JensGrabner/snc98_Slash-Number-Calculator/Hardware/Pdf/Switch_mechanical.pdf

< | >
E24 | (<)%
sin | cos | tan | 2

x

lb e

x

ln 10

x

lg
7 | 8 | 9 | ‹
›
CE | ( | ) | Off
sinh | cosh | tanh | Ip
·Fp | Aghm | a^gm
4 | 5 | 6 | ‹
›
< | × | -: | E+3

la

y a

x | x² | x.³ | Std | τ π | r/d // | %./p/
1 | 2 | 3 | Sci | ¹/x | + | - | E−3
Rd x! | °CBp | °FCk | inv | 2nd | M+=
hms | 0 | · | (-) | MCs | EE | FN | =

'-
° ' "
-'--- / ---' | '--Mr-'--M_--'
(·) Ex_ >] | '------DISP------'

show

a

b/c

## snc98 - Slash Number Calculator
