JensGrabner/snc98_Slash-Number-Calculator/Hardware/png/Switch_Calculator.png

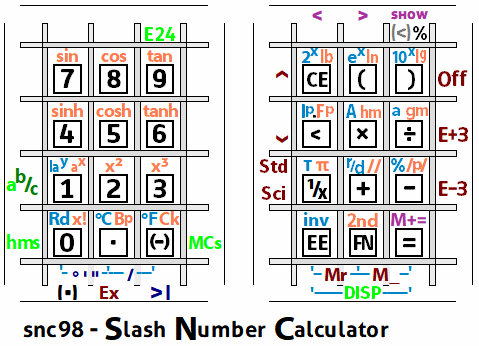
Hardware/png/Switch_Calculator.png
