JensGrabner/snc98_Slash-Number-Calculator/Software/Arduino/Projekte/snc98/Document/Font_HP15.png

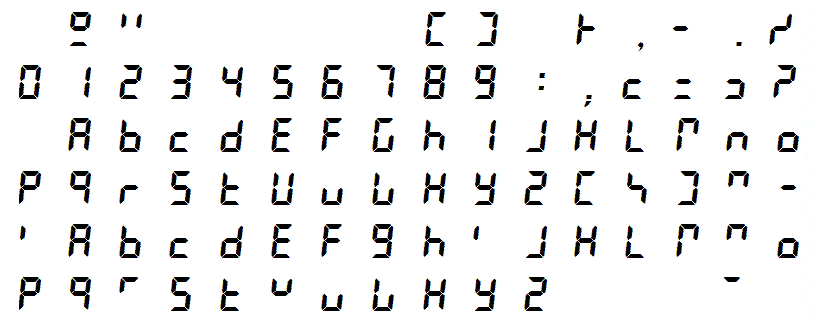
Software/Arduino/Projekte/snc98/Document/Font_HP15.png
