JensGrabner/snc98_Slash-Number-Calculator/Hardware/BOM/BOM_all.xls

Qty | Value | Device | Package | Parts | Description | MF | MPN | OC_FARNELL | OC_NEWARK | PACKAGE | STORE_ID | SUPPLIER | TME_EU
1 | PINHD-1X8 | 1X08-BIG | JP3 | Pin header 1x8 0.1 |  |  | unknown
1 | PINHD-1X9 | 1X09-BIG | JP15 | Pin header 1x9 0.1 |  |  | unknown
2 | PINHD-2X7 | 2X07 | JP13, JP14 | PIN HEADER |  |  | unknown |  |  |  |  |  | ZL231-14PG
2 | PIN_Flachband-2X7 |  |  |  |  |  | DS1016-14MASIBB |  |  |  |  |  | DS1016-14MASIBB
1 | 12MHz | CRYSTALHC49UV | HC49U-V | Y2 | Various standard cry |  |  | unknown
1 | ATMEGA1284P-PU | ATMEGA1284P-PU | DIP254P1524X483-40 | U3 | 8-bit Microcontrolle | MICROCHIP | ATMEGA1284P-PU | 1715481 | 15R0264 | PDIP-40 |  | Atmel
1 | BATTERY-CHARGER-LI-PROT | BATTERY-CHARGER-LI-PROT | BATTERY-CHARGER-LI-PROT | U$1 | Lithium Battery 5V C |  |  | unknown
1 | DS18B20 | DS18B20 | TO-92-AMMO | U2 | Dallas/Maxim DS18B20 |  |  | unknown |  |  | SEN-00245
1 | FTDI | M06LOCK | 1X06_LOCK | JP6 | Header 6 |  |  | unknown |  |  |  |  | ZL202-12G;
1 | ICSP | AVR_SPI_PRG_6 | 2X3_SMD_VERTICAL | JP1 | AVR ISP 6 Pin |  |  | unknown |  |  |  |  | ZL202-6G;
1 | B3F-4150 | TACTILE_SWITCHTACTILE_SWITCH_PTH-12MM | TACTILE-PTH-12MM | S3_c | Momentary Switch | OMRON | B3F4150 | 1960976 |  |  |  |  | B3F-4050
6 | HOLDER_AAA_LEFT1 | HOLDER_AAA_LEFT1 | BATTERY-AAA-LEFT | BH_c_7, BH_c_8, BH_c_9, BH_c_10, BH_c_11, BH_c_12 |  |  |  | unknown |  |  |  |  | BC-0401
1 | SBT1205-3 | BUZZERNS | BUZZER-12MM-NS | SG1 | Buzzer 12mm |  |  | unknown
1 | BCR185 | BCR185 | SOT23-R_INFINEON | T3 | PNP Silicon Digital | ROHM | DTA114YKAT146 | 1680186 |  |  |  |  | MMUN2114LT1G;
2 | BCR135 | BCR135 | SOT23-BEC | T1, T2 | NPN Silicon Digital | INFINEON | BCR135E6327HTSA1 | 2443491RL |  |  |  |  | MMUN2214LT1G;
1 | IRLML6244 | IRLML2502M | SOT-23 | M4 |  | INFINEON | IRLML6244TRPBF | 1864517 |  |  |  |  | DMG2302U-7
4 | IRLML2244 | IRLML6402 | SOT-23 | M1, M2, M3, M12 |  | INFINEON | IRLML2244TRPBF | 2468051 |  |  |  |  | DMG2305UX-7
1 | HT7333 / TS9011SCY | HT7333 | SOT89 | U$3 |  |  |  | unknown |  |  |  |  | TS9011SCY
6 | 1µ | C-EUC1206K | C1206K | C4, C9, C14, C15, C17, C19 | CAPACITOR, European |  |  | unknown |  |  |  |  | CL31B105KOFNNNE
1 | 4µ7 | C-EUC1206K | C1206K | C3 | CAPACITOR, European |  |  | unknown
1 | 74HC4051_MUX | 74HC4051_MUX | SO16 | U1 | 8:1 analog mux |  |  | unknown |  |  |  |  | 74HC4051D.652
9 | 6k8 | R-EU_R1206 | R1206 | R3, R7, R21, R22, R23, R27, R33, R34, R50 | RESISTOR, European s |  |  | unknown |  |  |  |  | SMD0805-6K8-1%
3 | 3k3 | R-EU_M0805 | R1206 | R35, R48, R51 | RESISTOR, European s |  |  | unknown |  |  |  |  | SMD0805-3K3-1%
1 | 1n | CAP0805 | 805 | C11 | Capacitor |  |  | unknown |  |  |  |  | CC0805KPX7R7224
3 | 15n | C-EUC1206K | C1206K | C6, C10, C22 | CAPACITOR, European |  |  | unknown |  |  |  |  | CC0805KRX7R9153
4 | 220nF | CAP0805 | 805 | C2, C12, C16, C18 | Capacitor |  |  | unknown |  |  |  |  | CC0805KPX7R7224
1 | 1k | R-EU_R1206 | R1206 | R20 | RESISTOR, European s |  |  | unknown
2 | 47n | C-EUC1206K | C1206K | C5, C13 | CAPACITOR, European |  |  | unknown |  |  |  |  | CC0805KRX7R9473
3 | 22k | R-EU_R1206 | R1206 | R6, R44, R47 | RESISTOR, European s |  |  | unknown |  |  |  |  | CRCW080522K0FKTABC;
3 | 47k | R-EU_R1206 | R1206 | R1, R28, R46 | RESISTOR, European s |  |  | unknown |  |  |  |  | CRCW080547K0FKTABC;
3 | 150R | R-EU_R1206 | R1206 | R31, R32, R45 | RESISTOR, European s |  |  | unknown |  |  |  |  | CRCW0805150RJNTABC;
2 | 47R | R-EU_R1206 | R1206 | R4, R25 | RESISTOR, European s |  |  | unknown
2 | 22pF | C-USC0805K | C0805K | C7, C8 | CAPACITOR, American |  |  | unknown |  |  |  |  | CL21C220JBANNNC
10 | SD103AW-DIO | DIODESOD-123 | SOD-123F | D02_c, D03_c, D04_c, D05_c, D07_c, D08_c, D09_c, D10_c, D11_c, D12_c |  | MULTICOMP | SD103AW-DIO-7-F | 2306221 |  |  |  |  | SD103AW-DIO;
8 | 3k3 | R-EU_M0805 | M0805 | R33, R34, R35, R44, R45, R46, R47, R48 | RESISTOR, European s |  |  | unknown |  |  |  |  | SMD0805-3K3-1%
8 | IRLML2244 | IRLML6402 | SOT-23 | M4, M5, M6, M7, M8, M9, M10, M11 |  | INFINEON | IRLML2244TRPBF | 2468051 |  |  |  |  | DMG2305UX-7
5 | BC56-12SRWA | BC56-12SRWA | BX56-12 | LED1, LED2, LED3, LED4, LED5 | 14.22mm (0.56INCH) T |  |  | unknown |  | LTD056AUE-103C;
2 | MICROMATCH-14 | MICROMATCH-14 | MICROMATCH-14 | X2, X4 | MicroMaTch 14 8-215 | AMP - TE CONNECTIVITY | 8-215464-4 | 3784678 | 19J6431 | DS1015-02-14R6;
3 | HOLDER_AAA_LEFT1 | HOLDER_AAA_LEFT1 | BATTERY-AAA-LEFT | BH_d_4, BH_d_5, BH_d_6 |  |  |  | unknown |  |  |  |  | BC-0401
3 | 6k8 | R-EU_M0805 | M0805 | R7_a, R8_a, R33_a | RESISTOR_a, European s |  |  | unknown |  |  |  |  | SMD0805-6K8-1%
12 | B3F-4150 | TACTILE_SWITCHTACTILE_SWITCH_PTH-12MM | TACTILE-PTH-12MM | S1_a, S2_a, S3_a, S4_a, S5_a, S6_a, S7_a, S8_a, S9_a, S10_a, S11_a, S12 | Momentary Switch |  | B3F4150 | 1960976 |  |  |  |  | B3F-4050
1 | M09LOCK-LONGPADS | M08LOCK-LONGPADS | 1X08_LOCK_LONGPADS | JP1_a | Header 8 |  |  | unknown | ;
12 | SD103AW-DIO | DIODESOD-123 | SOD-123F | D01_a, D02_a, D03_a, D04_a, D05_a, D06_a, D07_a, D08_a, D09_a, D10_a, D11_a, D12_a |  | MULTICOMP | SD103AW-DIO-7-F | 2306221 |  |  |  |  | SD103AW-DIO;
3 | 15n | C-EUC1206K | C1206K | C10_b, C11_b, C12_b | CAPACITOR_b, European |  |  | unknown |  |  |  |  | CC0805KRX7R9153
3 | 27k | R-EU_M0805 | M0805 | R9_b, R10_b, R11_b | RESISTOR_b, European s |  |  | unknown | RC0805FR-0727K;
3 | 6k8 | R-EU_M0805 | M0805 | R7_b, R8_b, R33_b | RESISTOR_b, European s |  |  | unknown |  |  |  |  | SMD0805-6K8-1%
12 | B3F-4150 | TACTILE_SWITCHTACTILE_SWITCH_PTH-12MM | TACTILE-PTH-12MM | S1_b, S2_b, S3_b, S4_b, S5_b, S6_b, S7_b, S8_b, S9_b, S10_b, S11_b, S12_b | Momentary Switch |  | B3F4150 | 1960976 |  |  |  |  | B3F-4050
1 | M09LOCK-LONGPADS | M09LOCK-LONGPADS | 1X09_LOCK_LONGPADS | JP1_b | Header 9 |  |  | unknown | ;
12 | SD103AW-DIO | DIODESOD-123 | SOD-123F | D01_b, D02_b, D03_b, D04_b, D05_b, D06_b, D07_b, D08_b, D09_b, D10_b, D11_b, D12_b |  | MULTICOMP | SD103AW-DIO-7-F | 2306221 |  |  |  |  | SD103AW-DIO;
