JensGrabner/snc98_Slash-Number-Calculator/Hardware/qcad/Switch_mechanical.dxf

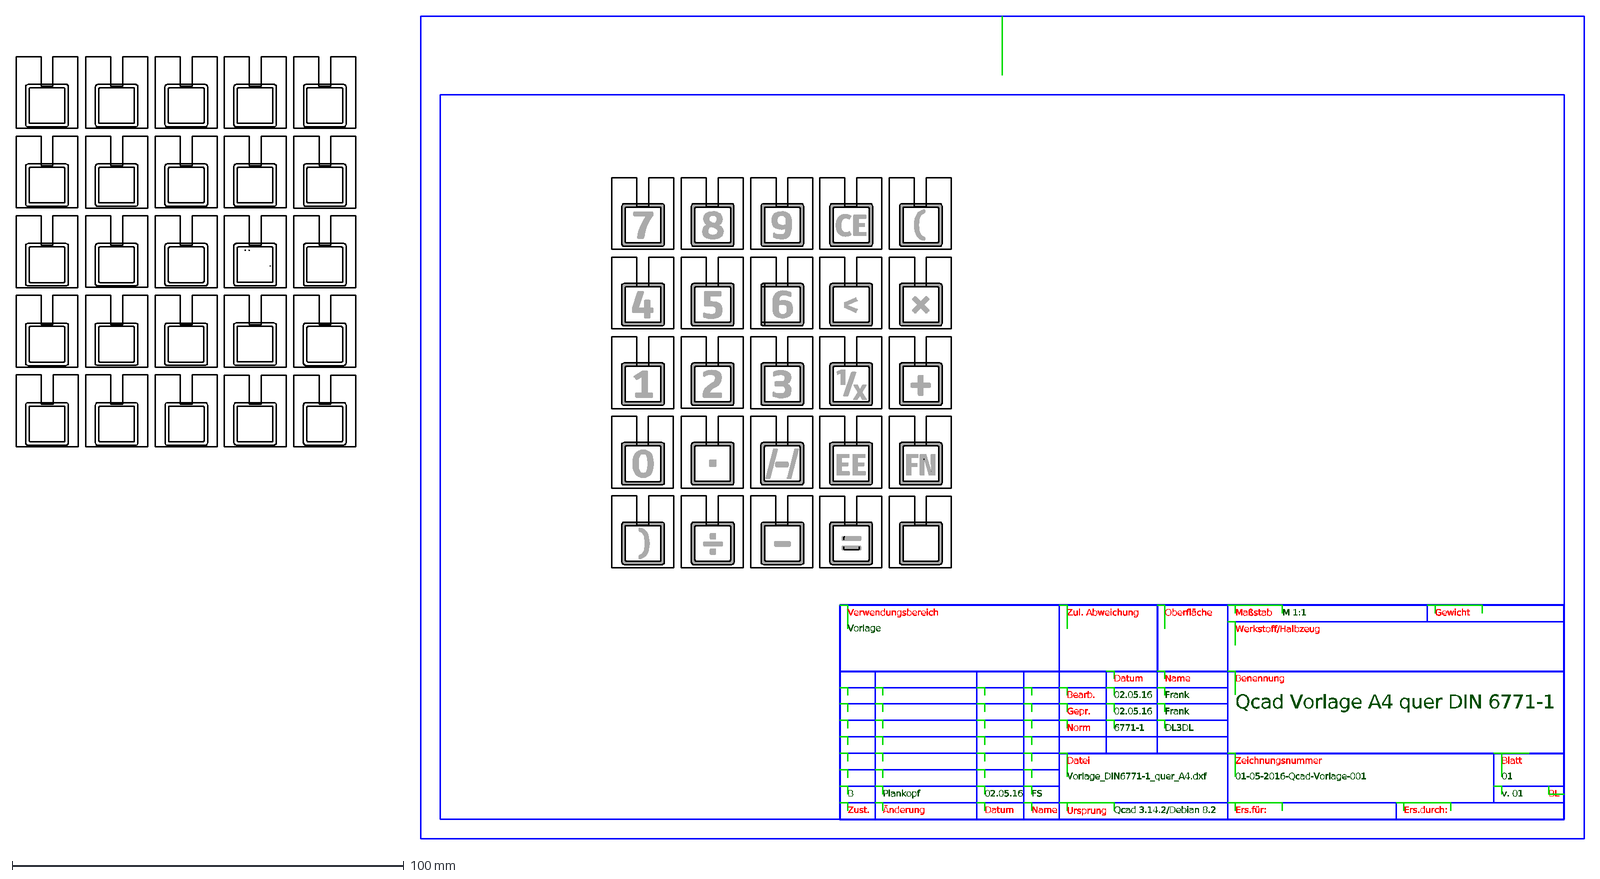
[picture p3: CAD file, 2017-12-26]
Hardware/qcad/Switch_mechanical.dxf
Verwendungsbereich
Zul. Abweichung
Oberfläche
Maßstab
Gewicht
Datum
Name
Bearb.
Gepr.
Norm
Zust.
Änderung
Ursprung
Ers.für:
Ers.durch:
Werkstoff/Halbzeug
Benennung
Zeichnungsnummer
Blatt
BL
B
Plankopf
02.05.16
FS
6771-1
Frank
Datei
Vorlage_DIN6771-1_quer_A4.dxf
01-05-2016-Qcad-Vorlage-001
01
v. 01
Vorlage
M 1:1
Qcad Vorlage A4 quer DIN 6771-1
Qcad 3.14.2/Debian 8.2
DL3DL
