JensGrabner/snc98_Slash-Number-Calculator/Software/Arduino/Projekte/snc98/Document/qbrt_test.xls

 |  |  | 4.12 | bit |  |  | 3.63 | bit |  |  | 7.27 | bit |  |  | 5.97 | bit |  |  | 10.39 | bit
0.125 | 0.500 | 0.5287 | 4.12 |  | 0.500 | 0.5403 | 3.63 |  | 0.500 | 0.5033 | 7.27 |  | 0.500 | 0.5080 | 5.97
0.130 | 0.507 | 0.532 | 4.33 |  | 0.507 | 0.543 | 3.79 |  | 0.507 | 0.509 | 7.80 |  | 0.507 | 0.513 | 6.37
0.135 | 0.513 | 0.535 | 4.56 |  | 0.513 | 0.546 | 3.96 |  | 0.513 | 0.514 | 8.51 |  | 0.513 | 0.517 | 6.84
0.140 | 0.519 | 0.538 | 4.81 |  | 0.519 | 0.549 | 4.13 |  | 0.519 | 0.520 | 9.69 |  | 0.519 | 0.522 | 7.47
0.145 | 0.525 | 0.541 | 5.09 |  | 0.525 | 0.552 | 4.32 |  | 0.525 | 0.525 | 13.07 |  | 0.525 | 0.527 | 8.45
0.150 | 0.531 | 0.544 | 5.41 |  | 0.531 | 0.555 | 4.51 |  | 0.531 | 0.531 | 9.62 |  | 0.531 | 0.532 | 11.34
0.155 | 0.537 | 0.547 | 5.80 |  | 0.537 | 0.557 | 4.73 |  | 0.537 | 0.536 | 8.79 |  | 0.537 | 0.536 | 9.08
0.160 | 0.543 | 0.550 | 6.29 |  | 0.543 | 0.560 | 4.96 |  | 0.543 | 0.541 | 8.32 |  | 0.543 | 0.541 | 8.03
0.165 | 0.548 | 0.553 | 6.97 |  | 0.548 | 0.563 | 5.22 |  | 0.548 | 0.546 | 8.02 |  | 0.548 | 0.545 | 7.48
0.170 | 0.554 | 0.556 | 8.18 |  | 0.554 | 0.566 | 5.52 |  | 0.554 | 0.551 | 7.81 |  | 0.554 | 0.550 | 7.12
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
