JensGrabner/snc98_Slash-Number-Calculator/Hardware/Pdf/snc98_3x4_Switch-block_brd.pdf

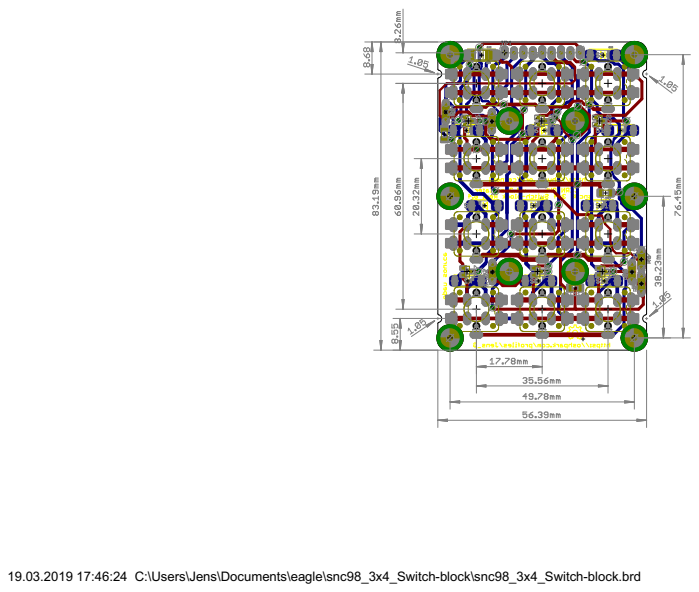
[picture p4: page 1]

19.03.2019 17:46:24 C:\Users\Jens\Documents\eagle\snc98_3x4_Switch-block\snc98_3x4_Switch-block.brd
