JensGrabner/snc98_Slash-Number-Calculator/Hardware/Pdf/snc98_3x4_Switch-block_sch.pdf

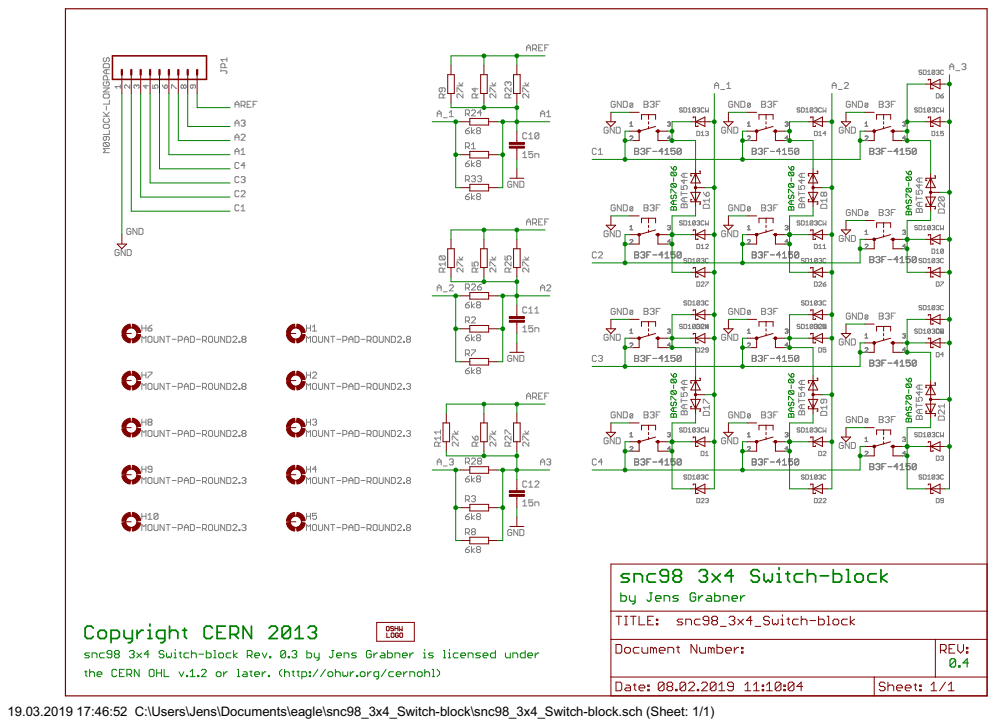
[picture p5: page 1]

19.03.2019 17:46:52 C:\Users\Jens\Documents\eagle\snc98_3x4_Switch-block\snc98_3x4_Switch-block.sch (Sheet: 1/1)
