JensGrabner/snc98_Slash-Number-Calculator/Hardware/Pdf/snc98_Display_15x7-Seg_3-digit_LTD056_brd.pdf

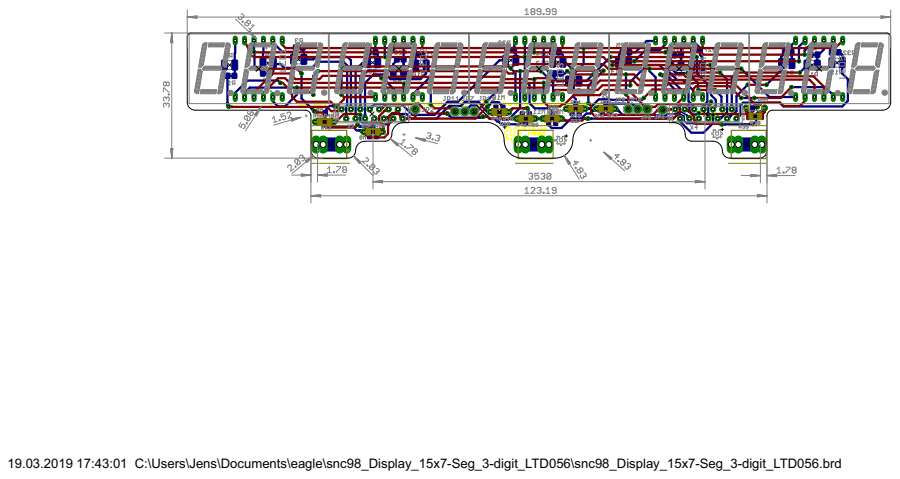
[picture p6: page 1]

19.03.2019 17:43:01 C:\Users\Jens\Documents\eagle\snc98_Display_15x7-Seg_3-digit_LTD056\snc98_Display_15x7-Seg_3-digit_LTD056.brd
