JensGrabner/snc98_Slash-Number-Calculator/Hardware/Pdf/snc98_Display_15x7-Seg_3-digit_LTD056_sch.pdf

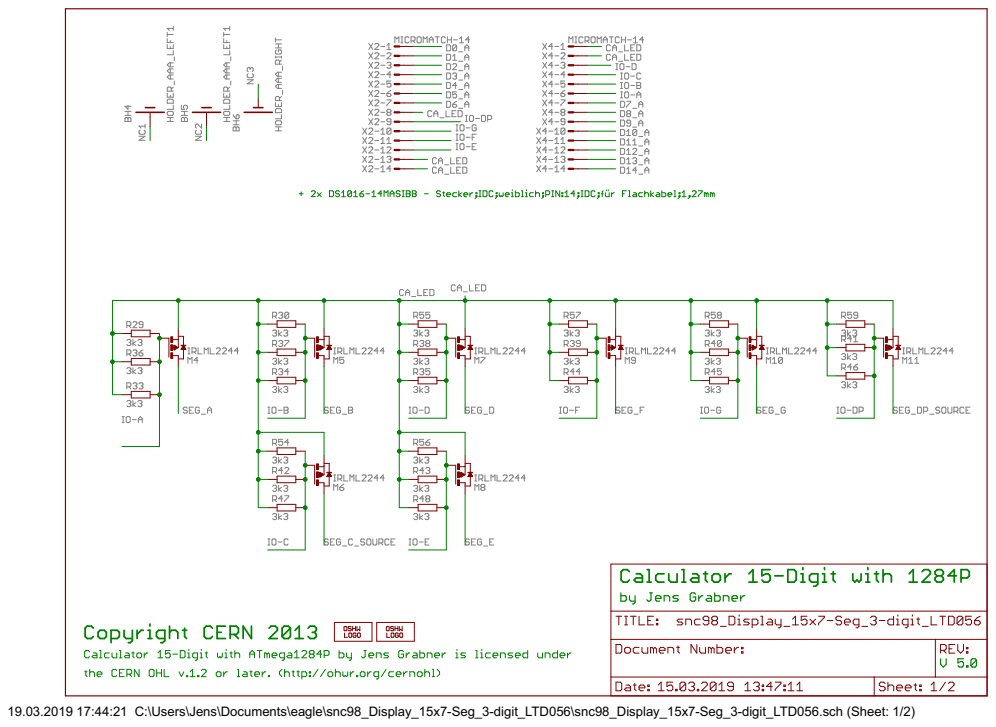
[picture p7: page 1]

19.03.2019 17:44:21 C:\Users\Jens\Documents\eagle\snc98_Display_15x7-Seg_3-digit_LTD056\snc98_Display_15x7-Seg_3-digit_LTD056.sch (Sheet: 1/2)

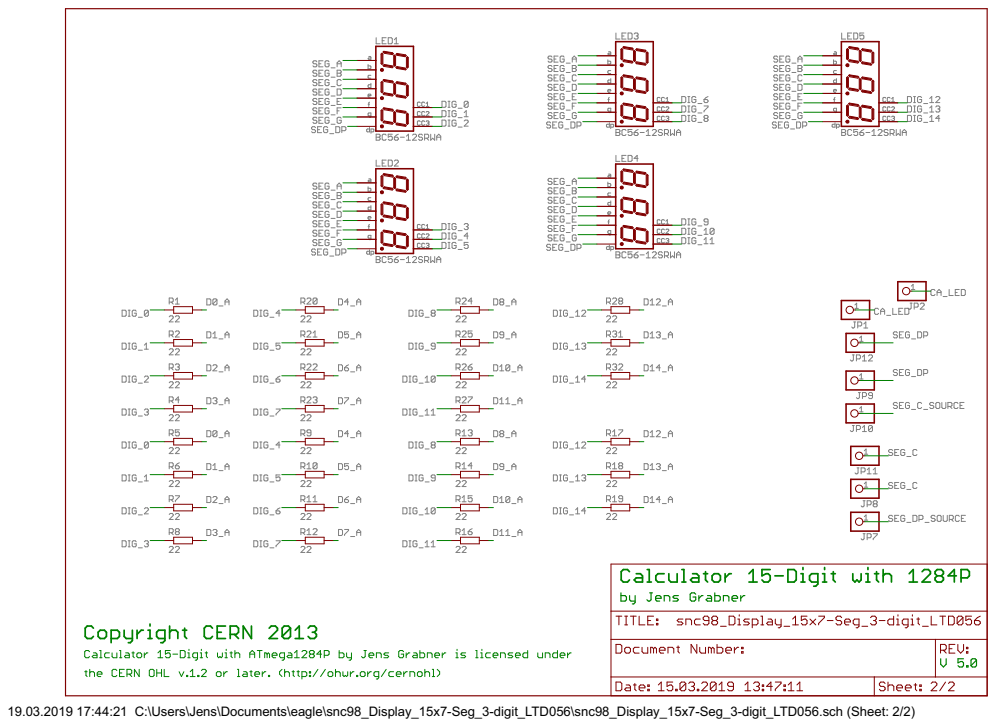
[picture p8: page 2]

19.03.2019 17:44:21 C:\Users\Jens\Documents\eagle\snc98_Display_15x7-Seg_3-digit_LTD056\snc98_Display_15x7-Seg_3-digit_LTD056.sch (Sheet: 2/2)
