JensGrabner/snc98_Slash-Number-Calculator/Hardware/Pdf/snc98_keyboard_plate_brd.pdf

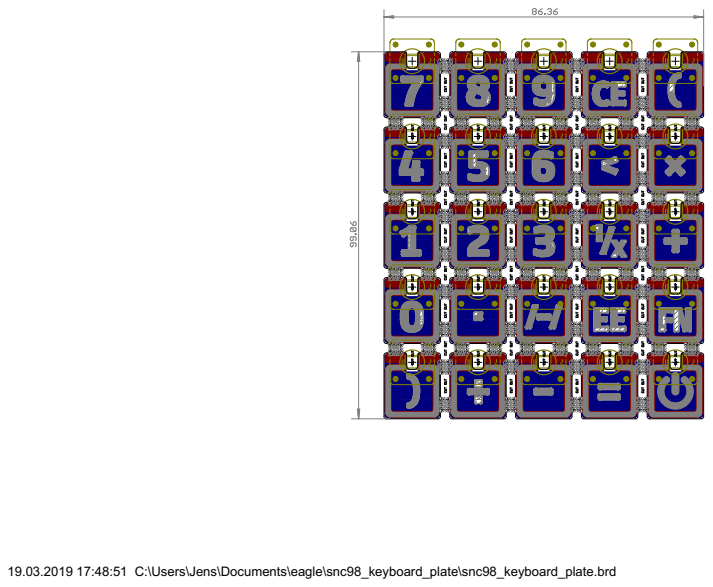
[picture p9: page 1]

19.03.2019 17:48:51 C:\Users\Jens\Documents\eagle\snc98_keyboard_plate\snc98_keyboard_plate.brd
