JensGrabner/snc98_Slash-Number-Calculator/Hardware/Pdf/snc98_keyboard_plate_sch.pdf

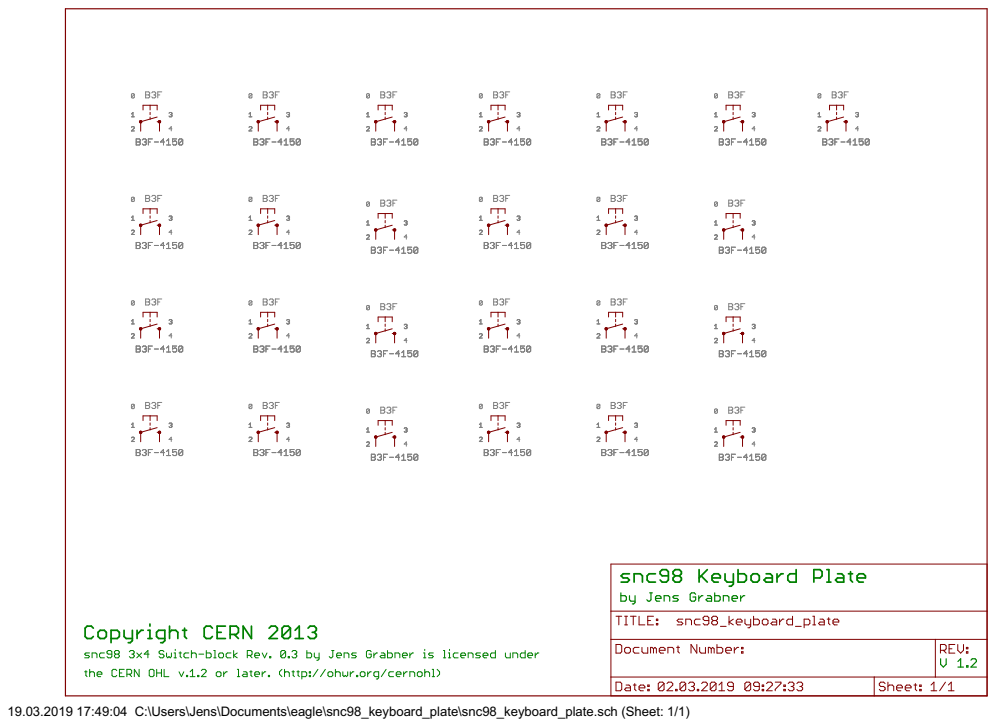
[picture p10: page 1]

19.03.2019 17:49:04 C:\Users\Jens\Documents\eagle\snc98_keyboard_plate\snc98_keyboard_plate.sch (Sheet: 1/1)
