JensGrabner/snc98_Slash-Number-Calculator/Hardware/Pdf/snc98_main_cpu_brd.pdf

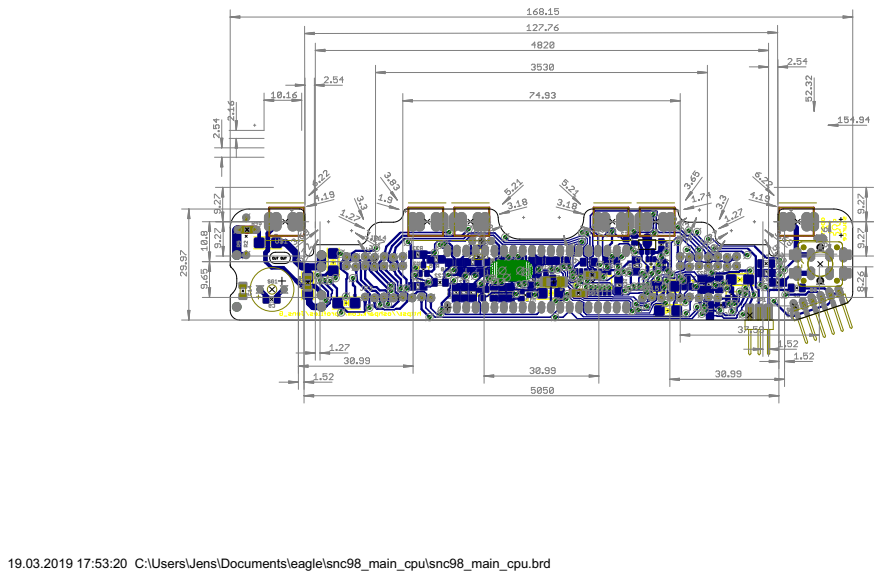
[picture p11: page 1]

19.03.2019 17:53:20 C:\Users\Jens\Documents\eagle\snc98_main_cpu\snc98_main_cpu.brd
