JensGrabner/snc98_Slash-Number-Calculator/Hardware/Pdf/snc98_main_cpu_sch.pdf

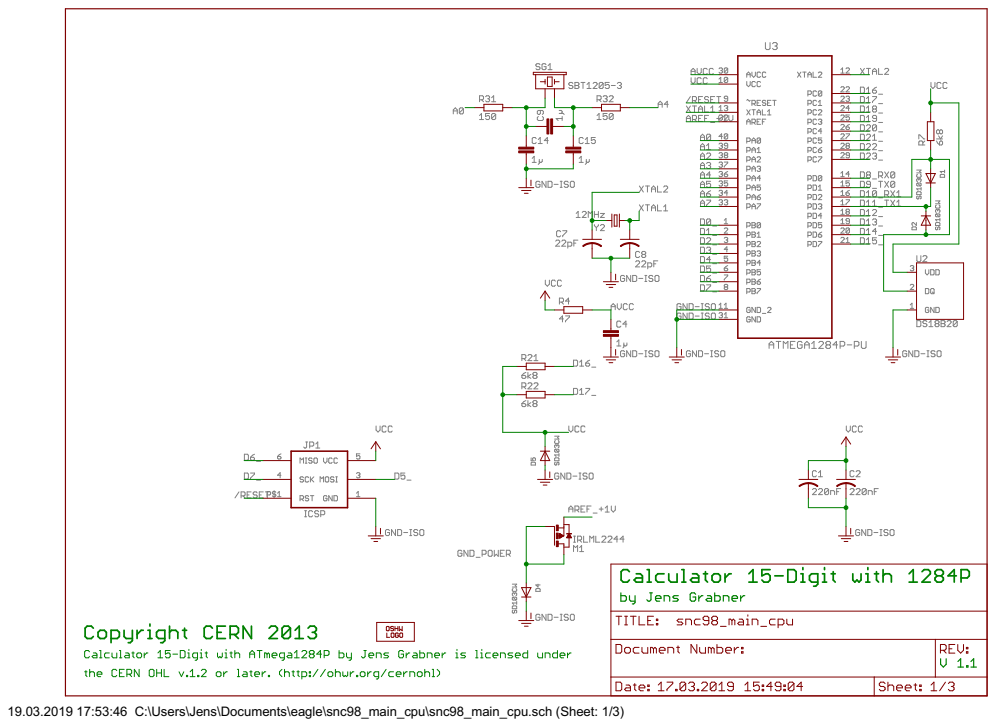
[picture p12: page 1]

19.03.2019 17:53:46 C:\Users\Jens\Documents\eagle\snc98_main_cpu\snc98_main_cpu.sch (Sheet: 1/3)

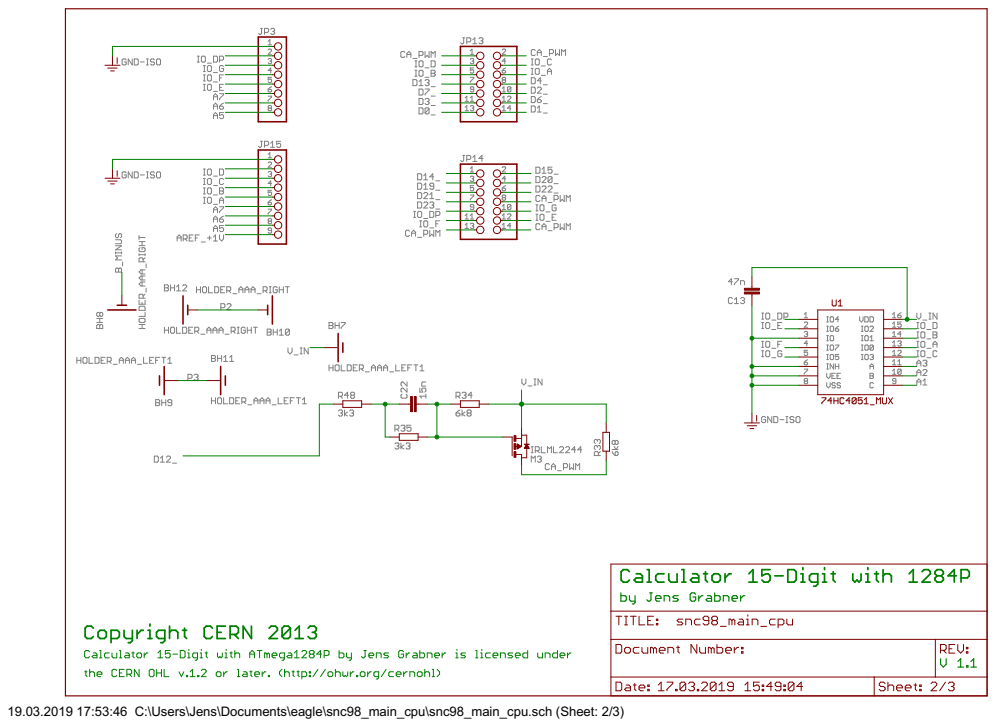
[picture p13: page 2]

19.03.2019 17:53:46 C:\Users\Jens\Documents\eagle\snc98_main_cpu\snc98_main_cpu.sch (Sheet: 2/3)

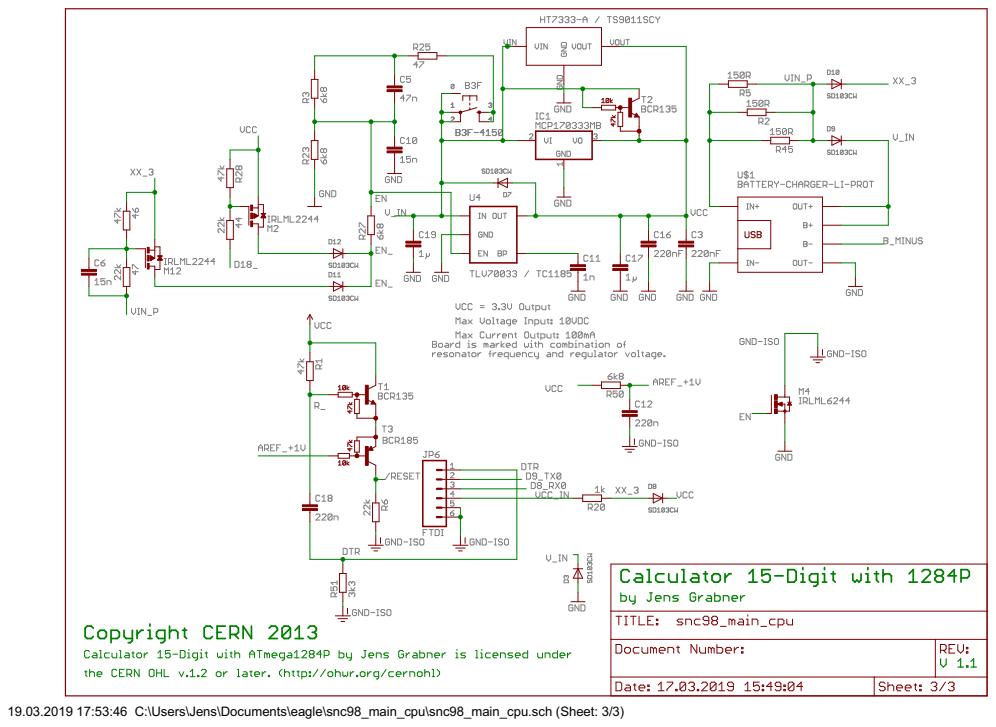
[picture p14: page 3]

19.03.2019 17:53:46 C:\Users\Jens\Documents\eagle\snc98_main_cpu\snc98_main_cpu.sch (Sheet: 3/3)
