JensGrabner/snc98_Slash-Number-Calculator/Hardware/Pdf/snc98_Display_15x7-Seg_1-digit_SC39_brd.pdf

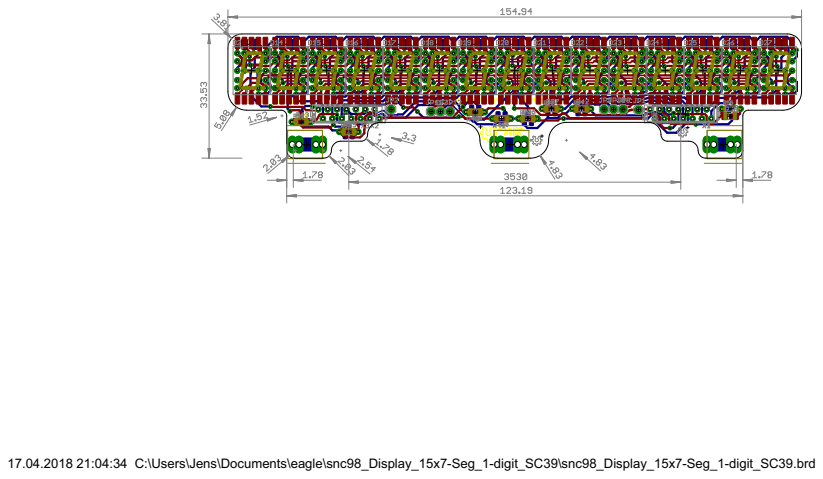
[picture p15: page 1]

17.04.2018 21:04:34 C:\Users\Jens\Documents\eagle\snc98_Display_15x7-Seg_1-digit_SC39\snc98_Display_15x7-Seg_1-digit_SC39.brd
