JensGrabner/snc98_Slash-Number-Calculator/Hardware/Pdf/snc98_Display_15x7-Seg_1-digit_SC39_sch.pdf

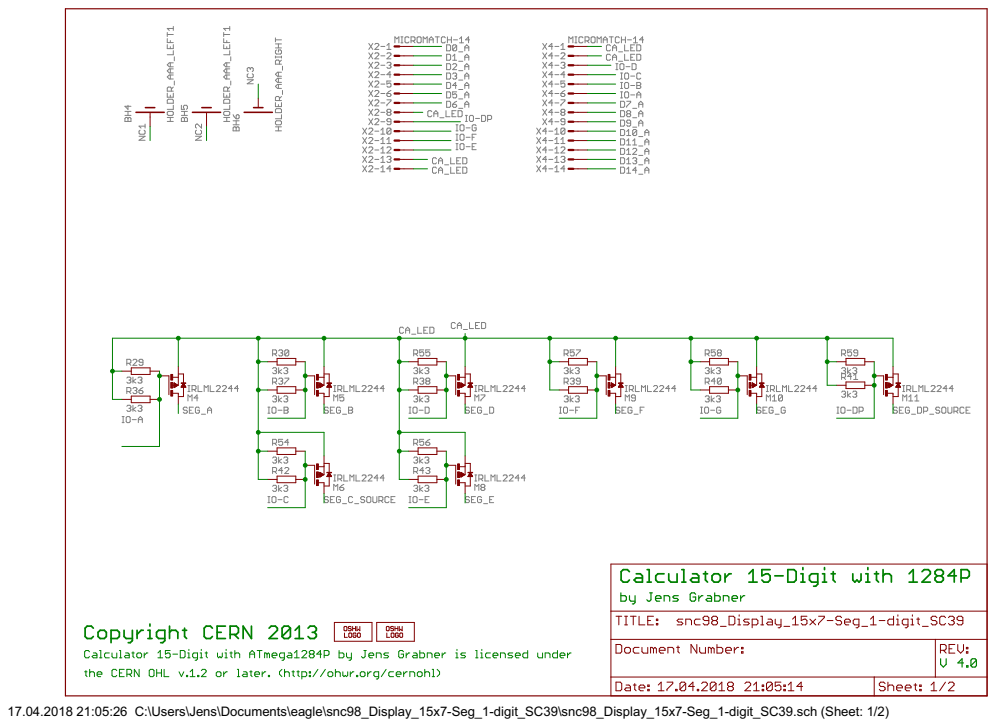
[picture p16: page 1]

17.04.2018 21:05:26 C:\Users\Jens\Documents\eagle\snc98_Display_15x7-Seg_1-digit_SC39\snc98_Display_15x7-Seg_1-digit_SC39.sch (Sheet: 1/2)

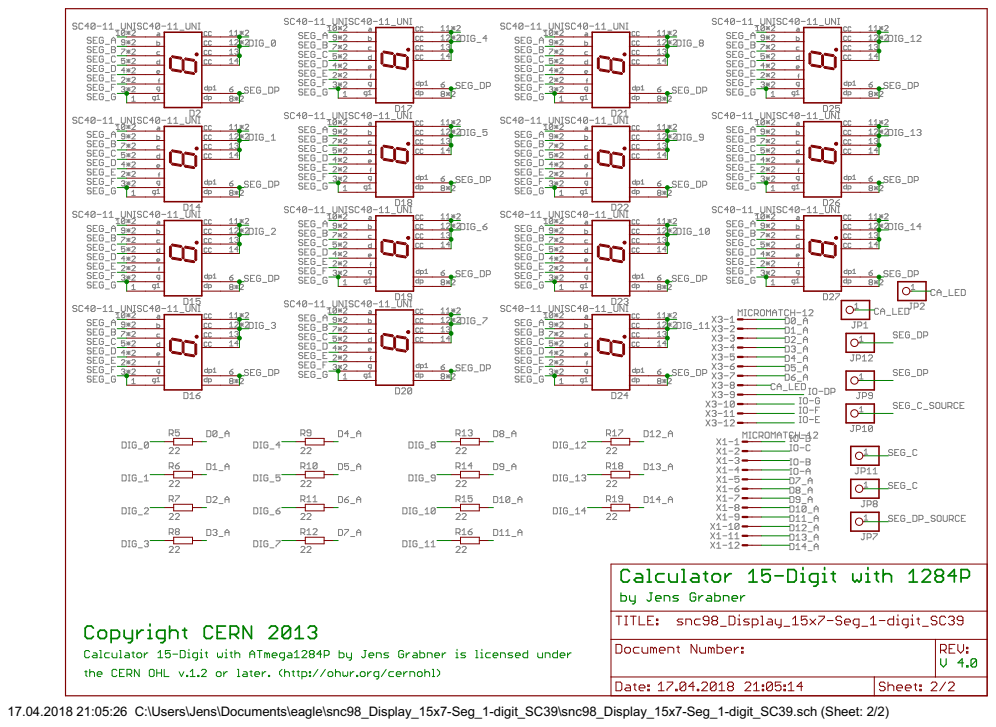
[picture p17: page 2]

17.04.2018 21:05:26 C:\Users\Jens\Documents\eagle\snc98_Display_15x7-Seg_1-digit_SC39\snc98_Display_15x7-Seg_1-digit_SC39.sch (Sheet: 2/2)
