JensGrabner/snc98_Slash-Number-Calculator/Hardware/Pdf/snc98_Display_15x7-Seg_1-digit_SC52_brd.pdf

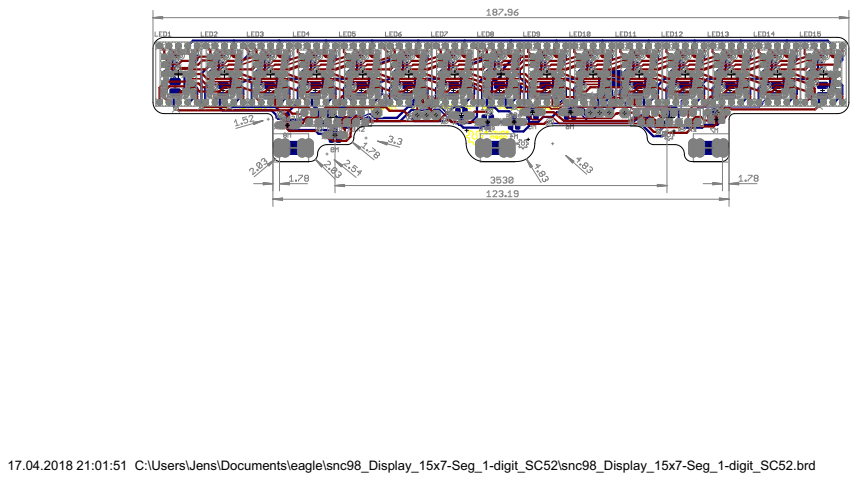
[picture p18: page 1]

17.04.2018 21:01:51 C:\Users\Jens\Documents\eagle\snc98_Display_15x7-Seg_1-digit_SC52\snc98_Display_15x7-Seg_1-digit_SC52.brd
