JensGrabner/snc98_Slash-Number-Calculator/Hardware/Pdf/snc98_Display_15x7-Seg_1-digit_SC52_sch.pdf

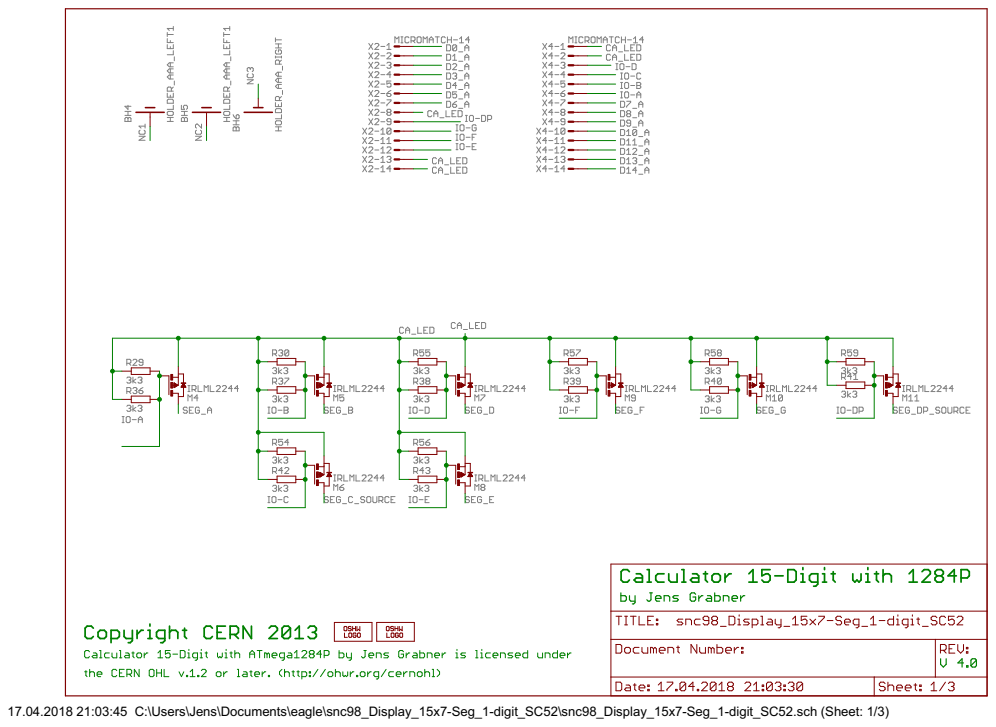
[picture p19: page 1]

17.04.2018 21:03:45 C:\Users\Jens\Documents\eagle\snc98_Display_15x7-Seg_1-digit_SC52\snc98_Display_15x7-Seg_1-digit_SC52.sch (Sheet: 1/3)

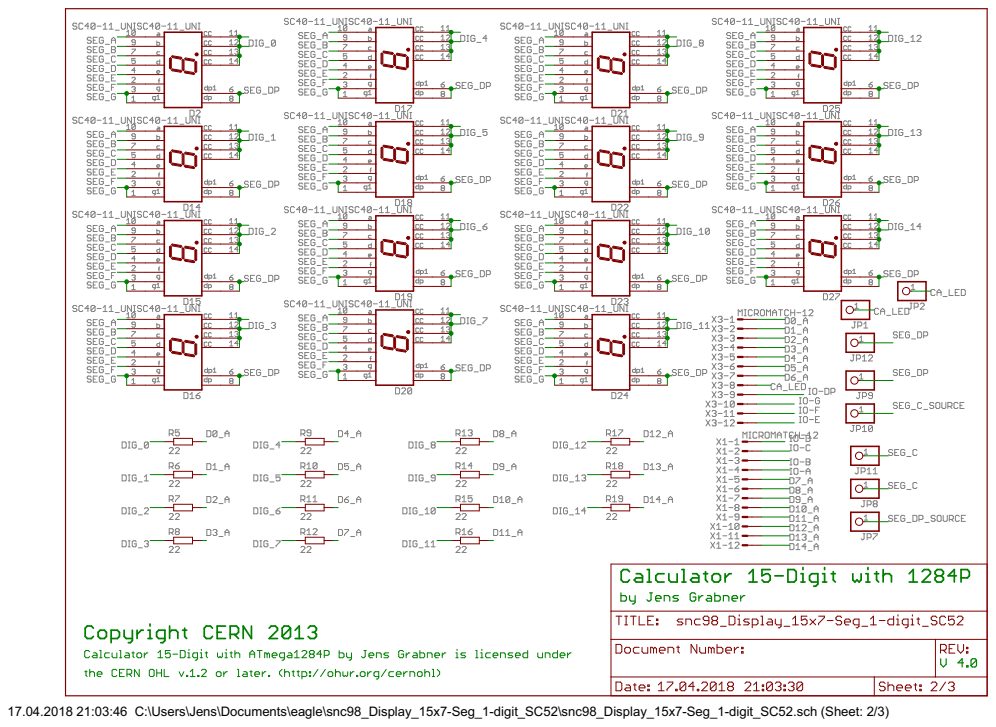
[picture p20: page 2]

17.04.2018 21:03:46 C:\Users\Jens\Documents\eagle\snc98_Display_15x7-Seg_1-digit_SC52\snc98_Display_15x7-Seg_1-digit_SC52.sch (Sheet: 2/3)

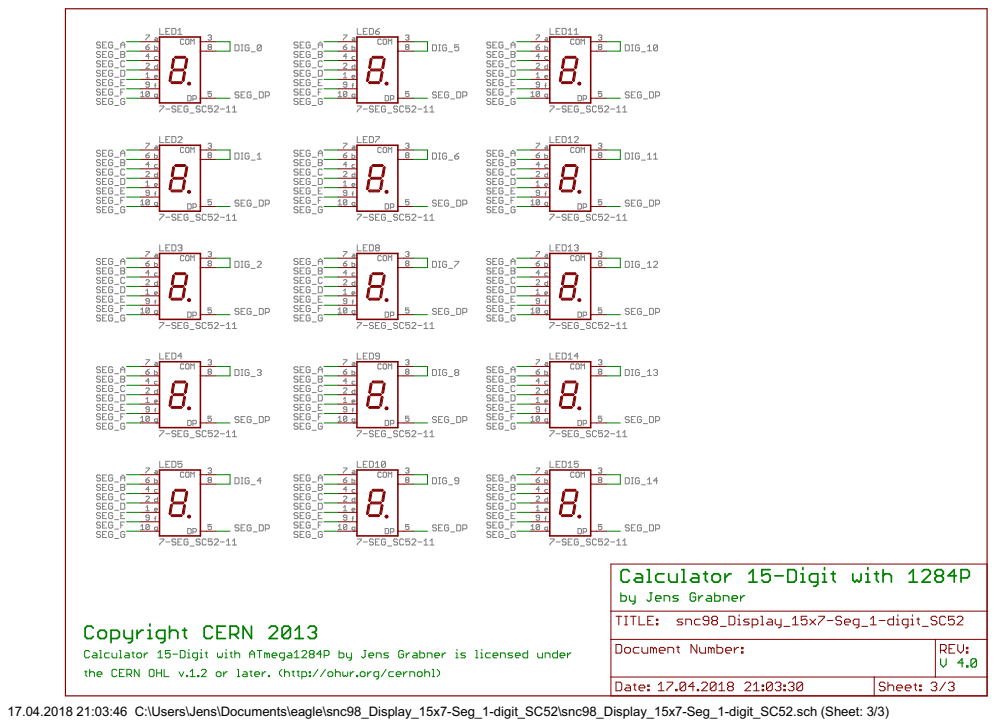
[picture p21: page 3]

17.04.2018 21:03:46 C:\Users\Jens\Documents\eagle\snc98_Display_15x7-Seg_1-digit_SC52\snc98_Display_15x7-Seg_1-digit_SC52.sch (Sheet: 3/3)
