JensGrabner/snc98_Slash-Number-Calculator/Hardware/Pdf/snc98_Display_15x7-Seg_3-digit_LTD040_brd.pdf

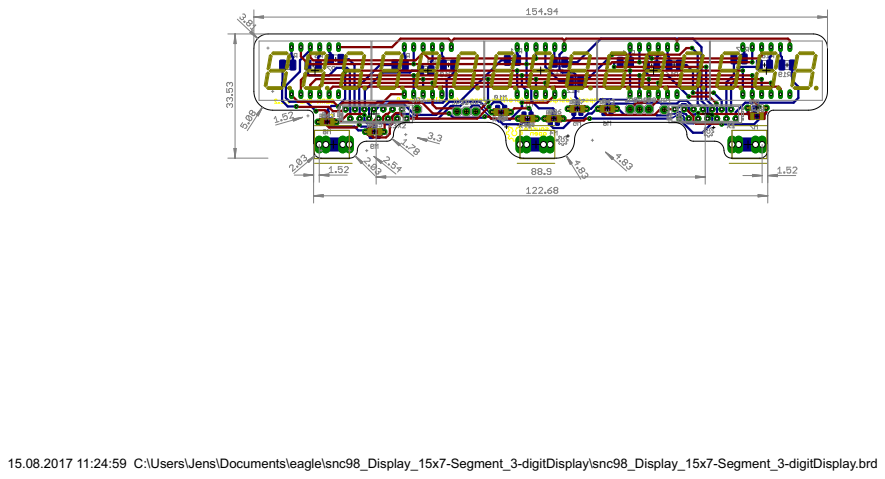
[picture p22: page 1]

15.08.2017 11:24:59 C:\Users\Jens\Documents\eagle\snc98_Display_15x7-Segment_3-digitDisplay\snc98_Display_15x7-Segment_3-digitDisplay.brd
