JensGrabner/snc98_Slash-Number-Calculator/Hardware/Pdf/snc98_Display_15x7-Seg_3-digit_LTD040_sch.pdf

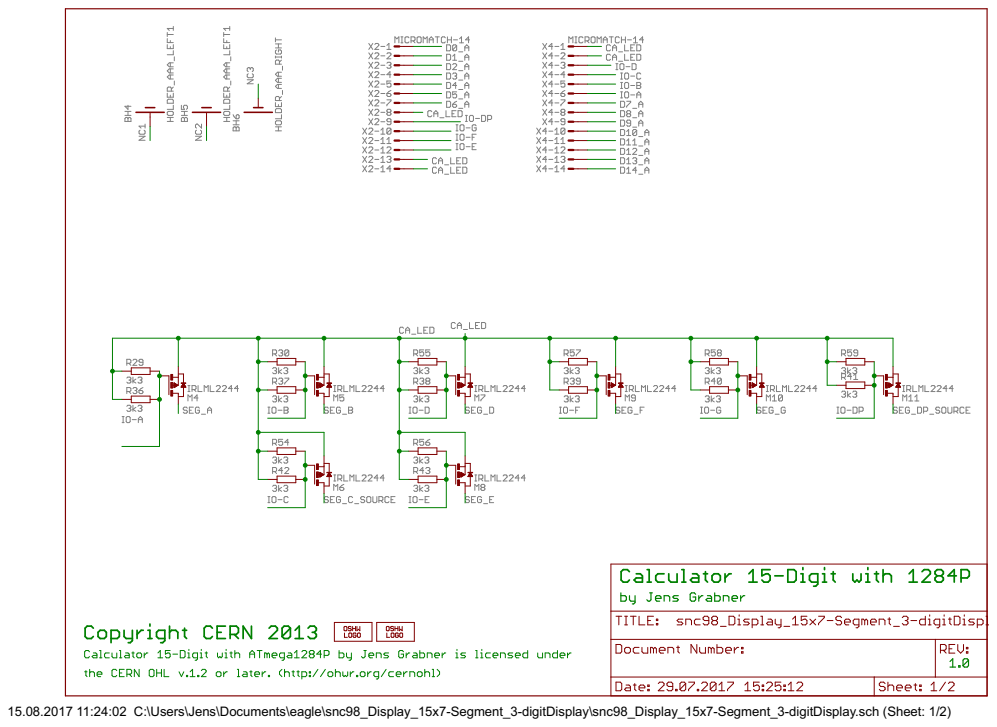
[picture p23: page 1]

15.08.2017 11:24:02 C:\Users\Jens\Documents\eagle\snc98_Display_15x7-Segment_3-digitDisplay\snc98_Display_15x7-Segment_3-digitDisplay.sch (Sheet: 1/2)

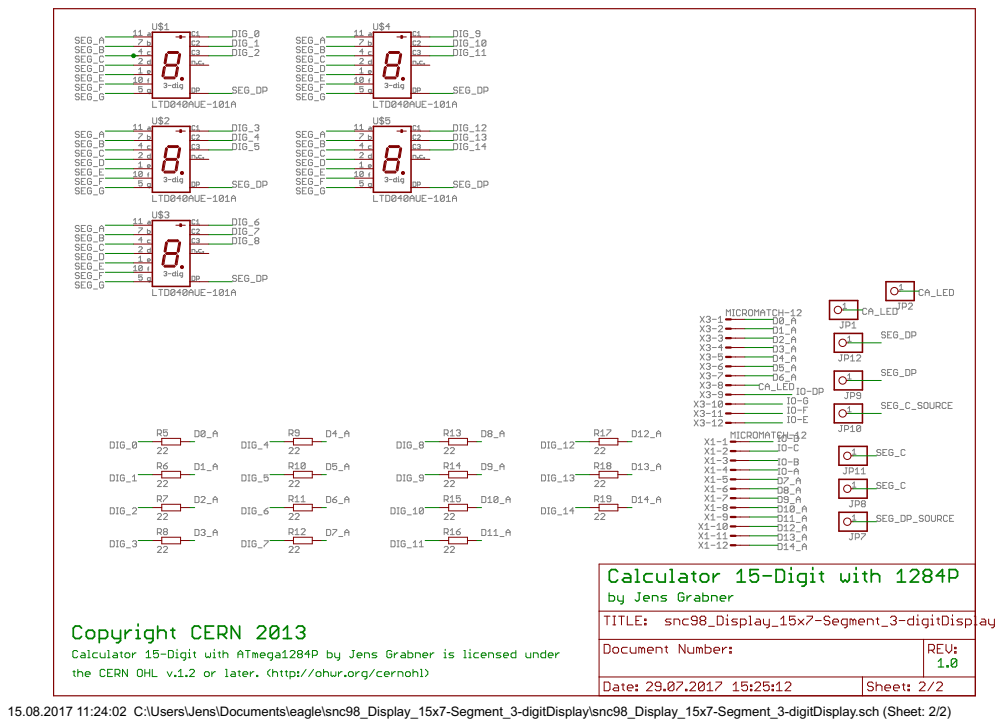
[picture p24: page 2]

15.08.2017 11:24:02 C:\Users\Jens\Documents\eagle\snc98_Display_15x7-Segment_3-digitDisplay\snc98_Display_15x7-Segment_3-digitDisplay.sch (Sheet: 2/2)
