JensGrabner/snc98_Slash-Number-Calculator/Hardware/eagle/6_6_0/snc98_main_cpu.brd

## EAGLE design Hardware/eagle/6_6_0/snc98_main_cpu.brd (2022-08-05)

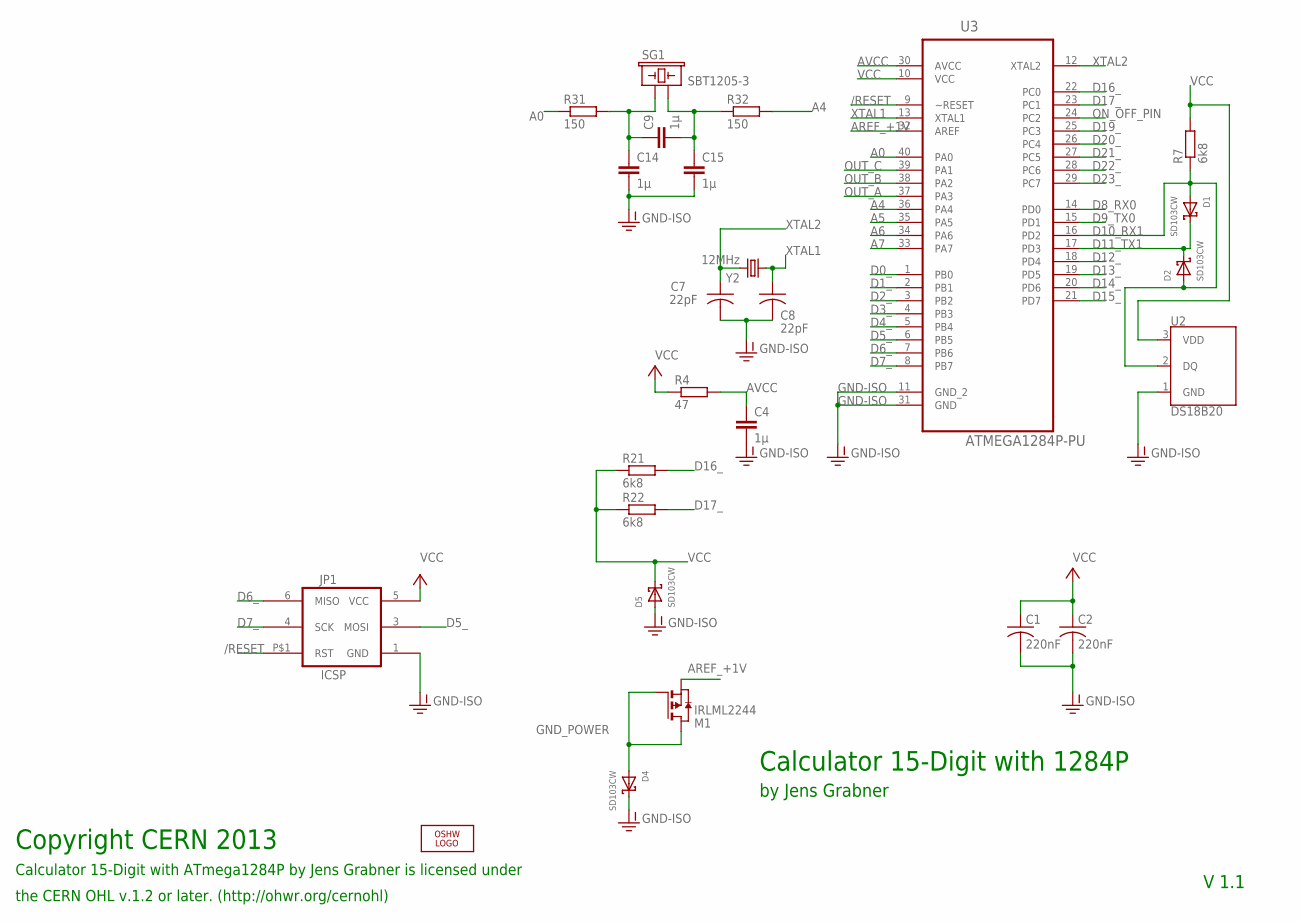
[picture p25: schematic snc98_main_cpu.sch, sheet 1]

Parts:
C1, C2: 220nF; C1206K
C4, C9, C14, C15: 1µ; C1206K
C7, C8: 22pF; C0805K
D1: SD103CW; SOD-323; MPN SD103CW-7-F
D2: SD103CW; SOD-123; MPN SD103CW-7-F
D4, D5: SD103CW; SOD-123F; MPN SD103CW-7-F
JP1: ICSP; 2X3_SMD_VERTICAL
LOGO1: OSHW_LOGO_8MILX0150-NT; OSHW_8X150_NOTEXT
M1: IRLML2244; SOT-23; MPN IRLML2244TRPBF
R4: 47; R1206
R7, R21, R22: 6k8; R1206
R31, R32: 150; R1206
SG1: SBT1205-3; BUZZER-12MM-NS
U2: DS18B20; TO-92-AMMO
U3: ATMEGA1284P-PU; DIP254P1524X483-40
Y2: 12MHz; HC49U-V

Connections:
/RESET: JP1.P$1 (RST), U3.9 (~RESET); also elsewhere on the board
A0: R31.1, U3.40 (PA0)
A4: R32.2, U3.36 (PA4)
A5: U3.35 (PA5); also elsewhere on the board
A6: U3.34 (PA6); also elsewhere on the board
A7: U3.33 (PA7); also elsewhere on the board
AREF_+1V: M1.2 (S), U3.32 (AREF); also elsewhere on the board
AVCC: C4.1, R4.2, U3.30 (AVCC)
D0_: U3.1 (PB0); also elsewhere on the board
D1_: U3.2 (PB1); also elsewhere on the board
D2_: U3.3 (PB2); also elsewhere on the board
D3_: U3.4 (PB3); also elsewhere on the board
D4_: U3.5 (PB4); also elsewhere on the board
D5_: JP1.3 (MOSI), U3.6 (PB5)
D6_: JP1.6 (MISO), U3.7 (PB6); also elsewhere on the board
D7_: JP1.4 (SCK), U3.8 (PB7); also elsewhere on the board
D8_RX0: U3.14 (PD0); also elsewhere on the board
D9_TX0: U3.15 (PD1); also elsewhere on the board
D10_RX1: D1.A, D2.A, R7.1, U2.2 (DQ), U3.16 (PD2)
D11_TX1: D1.C, D2.C, U3.17 (PD3)
D12_: U3.18 (PD4)
D13_: U3.19 (PD5); also elsewhere on the board
D14_: U3.20 (PD6); also elsewhere on the board
D15_: U3.21 (PD7); also elsewhere on the board
D16_: R21.2, U3.22 (PC0)
D17_: R22.2, U3.23 (PC1)
D19_: U3.25 (PC3); also elsewhere on the board
D20_: U3.26 (PC4); also elsewhere on the board
D21_: U3.27 (PC5); also elsewhere on the board
D22_: U3.28 (PC6); also elsewhere on the board
D23_: U3.29 (PC7); also elsewhere on the board
GND-ISO: C1.2, C2.2, C4.2, C7.2, C8.2, C14.2, C15.2, D4.C, D5.A, JP1.1 (GND), U2.1 (GND), U3.11 (GND_2), U3.31 (GND); also elsewhere on the board
GND_POWER: D4.A, M1.1 (G), M1.3 (D)
unnamed: C9.2, C15.1, R32.1, SG1.- (2)
unnamed: C9.1, C14.1, R31.2, SG1.+ (1)
ON_OFF_PIN: U3.24 (PC2); also elsewhere on the board
OUT_A: U3.37 (PA3); also elsewhere on the board
OUT_B: U3.38 (PA2); also elsewhere on the board
OUT_C: U3.39 (PA1); also elsewhere on the board
VCC: C1.1, C2.1, D5.C, JP1.5 (VCC), R4.1, R7.2, R21.1, R22.1, U2.3 (VDD), U3.10 (VCC); also elsewhere on the board
XTAL1: C8.1, U3.13 (XTAL1), Y2.1
XTAL2: C7.1, U3.12 (XTAL2), Y2.2

Notes on the sheet:
Calculator 15-Digit with 1284P
by Jens Grabner
V 1.1
Calculator 15-Digit with ATmega1284P by Jens Grabner is licensed under
Copyright CERN 2013
the CERN OHL v.1.2 or later. (http://ohwr.org/cernohl)

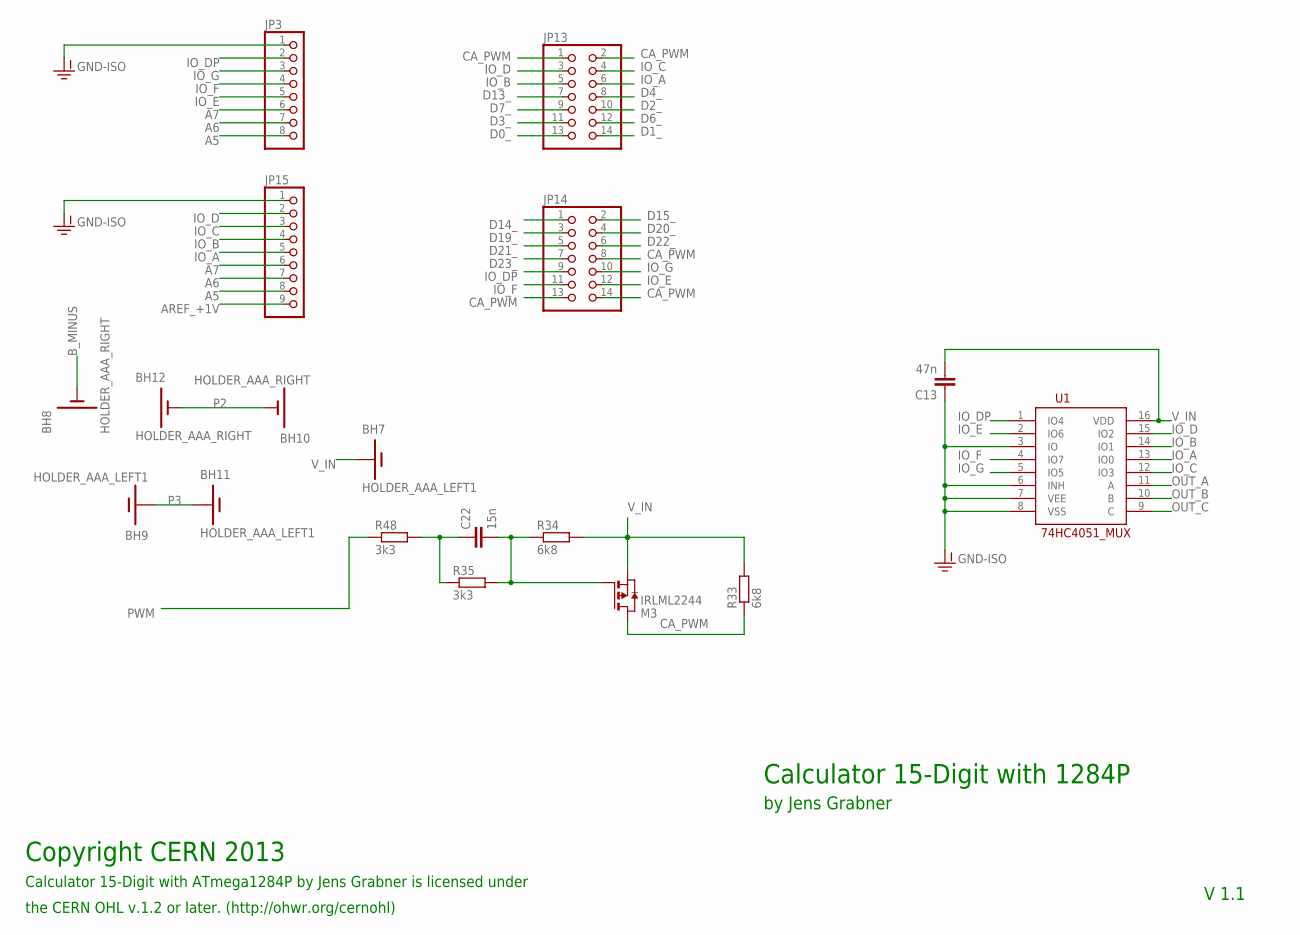
[picture p26: schematic snc98_main_cpu.sch, sheet 2]

Parts:
BH7, BH9, BH11: HOLDER_AAA_LEFT1; BATTERY-AAA-LEFT
BH8, BH10, BH12: HOLDER_AAA_RIGHT; BATTERY-AAA-RIGHT
C13: 47n; C1206K
C22: 15n; C1206K
JP3: PINHD-1X8CLEANBIG; 1X08-CLEANBIG
JP13, JP14: PINHD-2X7; 2X07
JP15: PINHD-1X9; 1X09-BIG
M3: IRLML2244; SOT-23; MPN IRLML2244TRPBF
R33, R34: 6k8; R1206
R35, R48: 3k3; R1206
U1: 74HC4051_MUX; SO16

Connections:
A5: JP3.8, JP15.8; also elsewhere on the board
A6: JP3.7, JP15.7; also elsewhere on the board
A7: JP3.6, JP15.6; also elsewhere on the board
A8: C22.1, R35.1, R48.2
AREF_+1V: JP15.9; also elsewhere on the board
B_MINUS: BH8.M1, BH8.M2, BH8.M3, BH8.M4; also elsewhere on the board
CA_PWM: JP13.1, JP13.2, JP14.8, JP14.13, JP14.14, M3.3 (D), R33.1
D0_: JP13.13; also elsewhere on the board
D1_: JP13.14; also elsewhere on the board
D2_: JP13.10; also elsewhere on the board
D3_: JP13.11; also elsewhere on the board
D4_: JP13.8; also elsewhere on the board
D6_: JP13.12; also elsewhere on the board
D7_: JP13.9; also elsewhere on the board
D13_: JP13.7; also elsewhere on the board
D14_: JP14.1; also elsewhere on the board
D15_: JP14.2; also elsewhere on the board
D19_: JP14.3; also elsewhere on the board
D20_: JP14.4; also elsewhere on the board
D21_: JP14.5; also elsewhere on the board
D22_: JP14.6; also elsewhere on the board
D23_: JP14.7; also elsewhere on the board
GND-ISO: C13.1, JP3.1, JP15.1, U1.3 (IO), U1.6 (INH), U1.7 (VEE), U1.8 (VSS); also elsewhere on the board
IO_A: JP13.6, JP15.5, U1.13 (IO0)
IO_B: JP13.5, JP15.4, U1.14 (IO1)
IO_C: JP13.4, JP15.3, U1.12 (IO3)
IO_D: JP13.3, JP15.2, U1.15 (IO2)
IO_DP: JP3.2, JP14.9, U1.1 (IO4)
IO_E: JP3.5, JP14.12, U1.2 (IO6)
IO_F: JP3.4, JP14.11, U1.4 (IO7)
IO_G: JP3.3, JP14.10, U1.5 (IO5)
unnamed: C22.2, M3.1 (G), R34.1, R35.2
OUT_A: U1.11 (A); also elsewhere on the board
OUT_B: U1.10 (B); also elsewhere on the board
OUT_C: U1.9 (C); also elsewhere on the board
P2: BH10.M1, BH10.M2, BH10.M3, BH10.M4, BH12.M1, BH12.M2, BH12.M3, BH12.M4
P3: BH9.P1, BH9.P2, BH9.P3, BH9.P4, BH11.P1, BH11.P2, BH11.P3, BH11.P4
PWM: R48.1
V_IN: BH7.P1, BH7.P2, BH7.P3, BH7.P4, C13.2, M3.2 (S), R33.2, R34.2, U1.16 (VDD); also elsewhere on the board

Notes on the sheet:
Calculator 15-Digit with 1284P
by Jens Grabner
V 1.1
Calculator 15-Digit with ATmega1284P by Jens Grabner is licensed under
Copyright CERN 2013
the CERN OHL v.1.2 or later. (http://ohwr.org/cernohl)

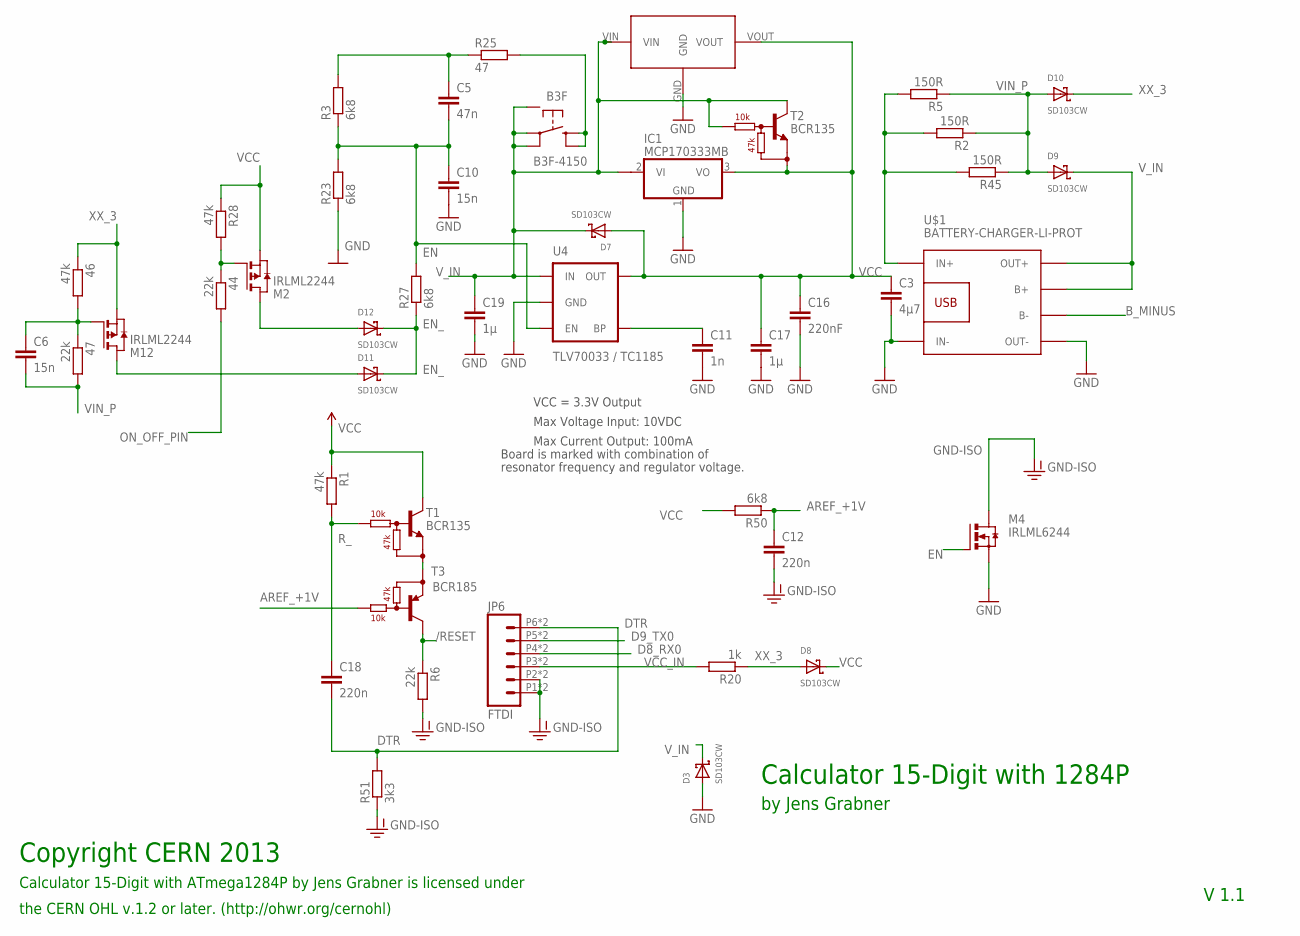
[picture p27: schematic snc98_main_cpu.sch, sheet 3]

Parts:
44, 47: 22k; R1206
46: 47k; R1206
C3: 4µ7; C1206K
C5: 47n; C1206K
C6, C10: 15n; C1206K
C11: 1n; 0805
C12: 220n; 0805
C16: 220nF; 0805
C17, C19: 1µ; C1206K
C18: 220n; C1206K
D3, D7, D8, D9, D10, D11, D12: SD103CW; SOD-123F; MPN SD103CW-7-F
IC1: MCP170333MB; SOT89
JP6: FTDI; 1X06_LOCK
M2, M12: IRLML2244; SOT-23; MPN IRLML2244TRPBF
M4: IRLML6244; SOT-23; MPN IRLML6244TRPBF
R1, R28: 47k; R1206
R2: 150R; 0204/5
R3, R23, R27, R50: 6k8; R1206
R5: 150R; 0207/10
R6: 22k; R1206
R20: 1k; R1206
R25: 47; R1206
R45: 150R; R1206
R51: 3k3; R1206
S3: B3F-4150; TACTILE-PTH-12MM; MPN B3F4150
T1, T2: BCR135; SOT23-BEC; MPN BCR135E6327HTSA1
T3: BCR185; SOT23-R_INFINEON; MPN DTA114YKAT146
U4: TLV70033 / TC1185; SOT23-5
U$1: BATTERY-CHARGER-LI-PROT
U$3: HT7333 / TS9011SCY; SOT89

Connections:
/RESET: R6.1, T3.C; also elsewhere on the board
A9: C5.1, R3.2, R25.1
AREF_+1V: C12.3 (1), R50.1, T3.B; also elsewhere on the board
B_MINUS: U$1.B-; also elsewhere on the board
CA_PWM1: D12.A, M2.3 (D)
CA_PWM2: D11.A, M12.3 (D)
D8_RX0: JP6.P4 (4), JP6.P4A (4); also elsewhere on the board
D9_TX0: JP6.P5 (5), JP6.P5A (5); also elsewhere on the board
DTR: C18.2, JP6.P6 (6), JP6.P6A (6), R51.2
EN: C5.2, C10.1, M4.1 (G), R3.1, R23.2, R27.2, U4.3 (EN)
EN_: D11.C, D12.C, R27.1
GND: C3.2, C10.2, C11.4 (2), C16.4 (2), C17.2, C19.2, D3.A, IC1.1 (GND), M4.2 (S), R23.1, U4.2 (GND), U$1.IN-, U$1.OUT-, U$3.GND
GND-ISO: C12.4 (2), JP6.P1 (1), JP6.P1A (1), JP6.P2 (2), JP6.P2A (2), M4.3 (D), R6.2, R51.1; also elsewhere on the board
unnamed: T1.E, T3.E
unnamed: C11.3 (1), U4.4 (BP)
unnamed: R25.2, S3.P$3 (3), S3.P$4 (4), S3.P$13 (3), S3.P$14 (4), S3.P$23 (3), S3.P$24 (4)
unnamed: 44.1, M2.1 (G), R28.2
unnamed: 46.2, 47.1, C6.1, M12.1 (G)
unnamed: R2.2, R5.2, R45.2, U$1.IN+
ON_OFF_PIN: 44.2; also elsewhere on the board
R_: C18.1, R1.2, T1.B
VCC: C3.1, C16.3 (1), C17.1, D7.A, D8.C, IC1.3 (VO), M2.2 (S), R1.1, R28.1, R50.2, T1.C, T2.E, U4.5 (OUT), U$3.VOUT; also elsewhere on the board
VCC_IN: JP6.P3 (3), JP6.P3A (3), R20.2
VIN_P: 47.2, C6.2, D9.A, D10.A, R2.1, R5.1, R45.1
V_IN: C19.1, D3.C, D7.C, D9.C, IC1.2@1 (VI1), S3.P$1 (1), S3.P$2 (2), S3.P$11 (1), S3.P$12 (2), S3.P$15 (5), S3.P$21 (1), S3.P$22 (2), T2.B, T2.C, U4.1 (IN), U$1.B+, U$1.OUT+, U$3.VIN; also elsewhere on the board
XX_3: 46.1, D8.A, D10.C, M12.2 (S), R20.1

Notes on the sheet:
Calculator 15-Digit with 1284P
by Jens Grabner
V 1.1
Calculator 15-Digit with ATmega1284P by Jens Grabner is licensed under
Copyright CERN 2013
the CERN OHL v.1.2 or later. (http://ohwr.org/cernohl)
Max Voltage Input: 10VDC
Max Current Output: 100mA
Board is marked with combination of
resonator frequency and regulator voltage.
VCC = 3.3V Output

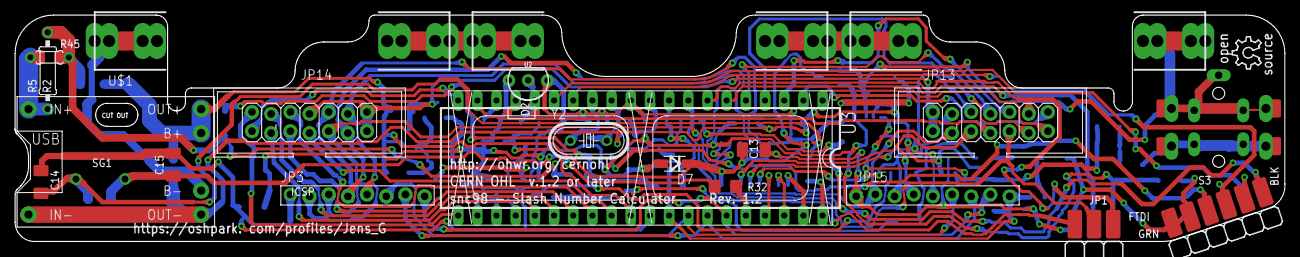
[picture p28: board snc98_main_cpu.brd from above]

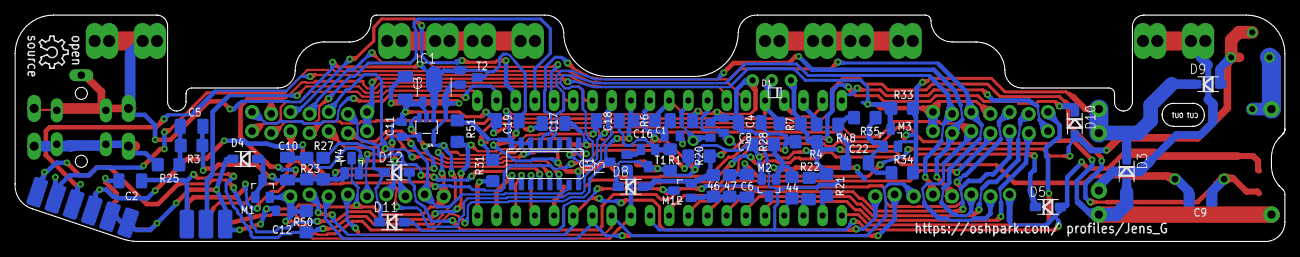
[picture p29: board snc98_main_cpu.brd from below]

Board: 2 copper layers, 168.2 x 30.0 mm, 89 parts (61 on the bottom side), 73 nets.

Other parts of the board:
LOGO2: OSHW_LOGO_8MILX0150-NT; OSHW_8X150_NOTEXT
