JensGrabner/snc98_Slash-Number-Calculator/Hardware/eagle/6_6_0/snc98_3x4_Switch-futuba.brd

## EAGLE design Hardware/eagle/6_6_0/snc98_3x4_Switch-futuba.brd (2021-11-27)

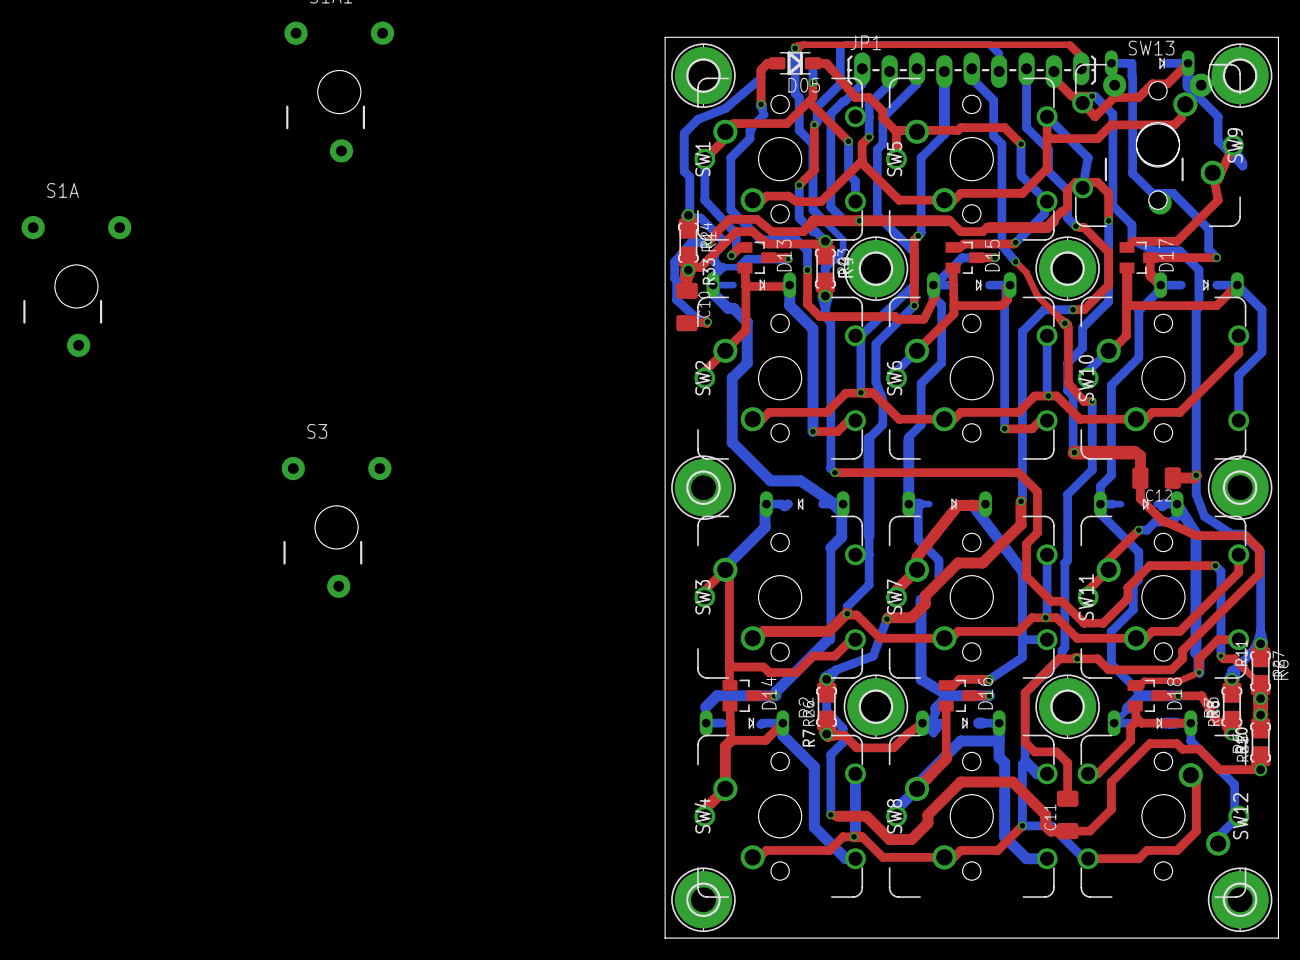
[picture p30: board snc98_3x4_Switch-futuba.brd from above]

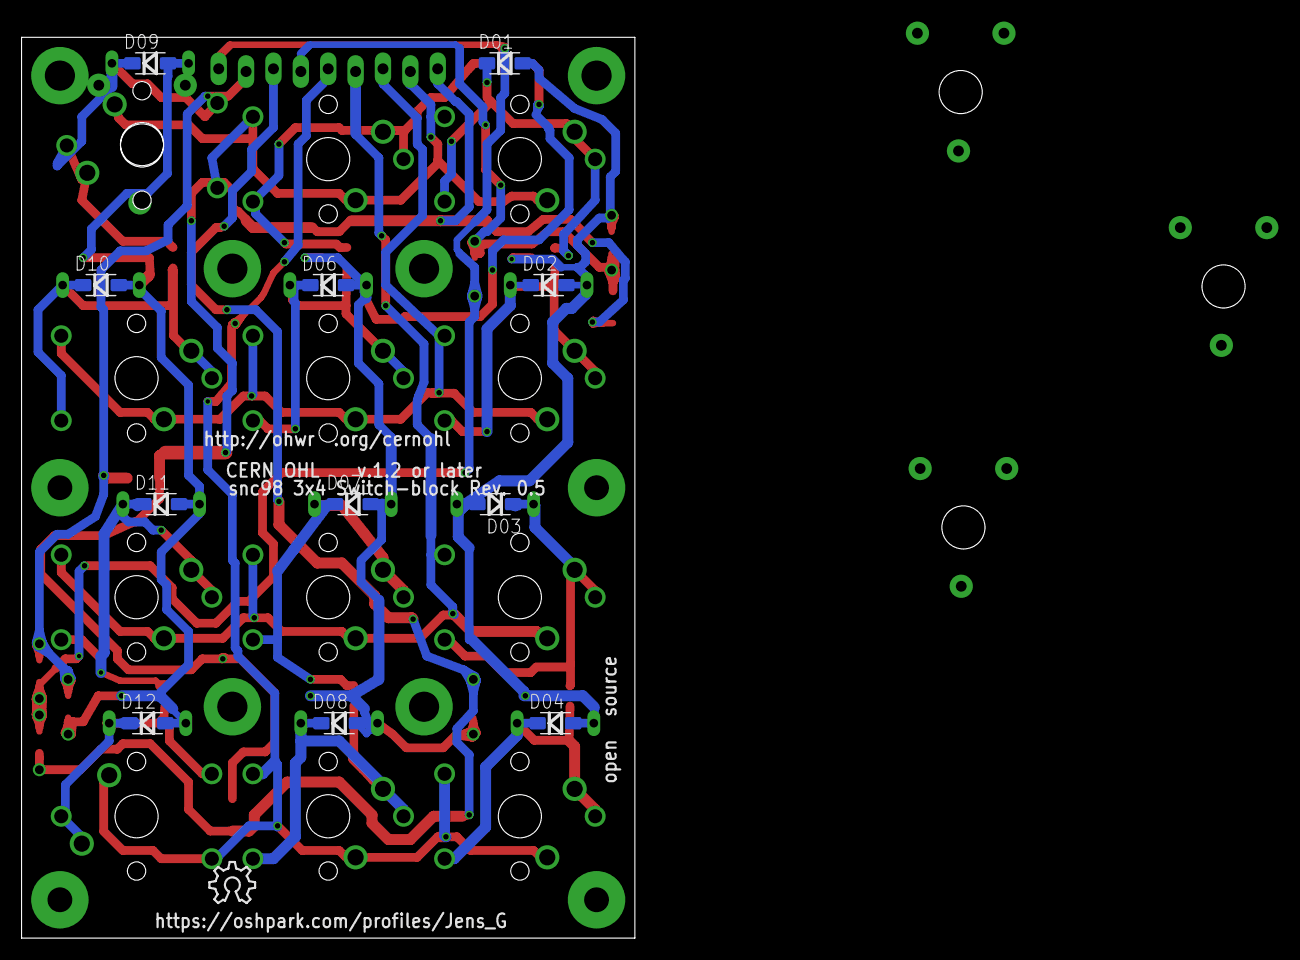
[picture p31: board snc98_3x4_Switch-futuba.brd from below]

Board: 2 copper layers, 56.9 x 83.6 mm, 77 parts (12 on the bottom side), 24 nets.

Parts:
C10, C11, C12: 15n; C1206K
D01, D02, D03, D04, D05, D06, D07, D08, D09: SD103AW-DIO; SOD-123F
D10, D11, D12: SD103CW; SOD-123F
D13, D14, D15, D16, D17, D18: BAT54A; SOT23
D19, D20, D21, D22, D23, D24, D25, D26, D27, D28: SD103C; 280MIL-TH
H1, H4, H5, H6, H7, H8: MOUNT-PAD-ROUND2.8; 2,8-PAD
H2, H3, H9, H10: MOUNT-PAD-ROUND2.3; 2,3-PAD
JP1: M09LOCK-LONGPADS; 1X09_LOCK_LONGPADS
LOGO1: OSHW_LOGO_8MILX0150-NT; OSHW_8X150_NOTEXT
R1, R2, R3: 6k8; R1206
R4, R5, R6: 27k; R1206
R7, R8, R33: 6k8; M0805
R9, R10, R11: 27k; M0805
R23, R25, R27: 27k; 0204/5
R24, R26, R28: 6k8; 0204/5
S1A, S1A1, S3: MX1A-XXNN
SW1, SW2, SW3, SW4, SW5, SW6, SW7, SW8, SW9, SW10, SW11, SW12: CHERRY_MX_WITH_FIXING_PINS; MX1A-XXNW
SW13: CHERRY_MX; MX1A-XXNN

Connections:
A1: C10.1, JP1.6, R1.2, R4.1, R9.1, R23.1, R24.2, R33.2
A2: C11.1, JP1.7, R2.2, R5.1, R7.2, R10.1, R25.1, R26.2
A3: C12.1, JP1.8, R3.2, R6.1, R8.2, R11.1, R27.1, R28.2
AREF: JP1.9, R4.2, R5.2, R6.2, R9.2, R10.2, R11.2, R23.2, R25.2, R27.2
A_1: D01.A, D02.A, D03.A, D04.A, D13.3, D14.3, D19.P$1, D20.P$1, D21.P$1, R1.1, R24.1, R33.1
A_2: D05.A, D06.A, D07.A, D08.A, D15.3, D16.3, D22.P$1, D23.P$1, D24.P$1, R2.1, R7.1, R26.1
A_3: D09.A, D10.A, D11.A, D12.A, D17.3, D18.3, D25.P$1, D26.P$1, D27.P$1, D28.P$1, R3.1, R8.1, R28.1
C1: JP1.2, SW1.1, SW1.3, SW5.1, SW5.3, SW9.1, SW9.3
C2: JP1.3, SW2.1, SW2.3, SW6.1, SW6.3, SW10.1, SW10.3
C3: JP1.4, SW3.1, SW3.3, SW7.1, SW7.3, SW11.1, SW11.3
C4: JP1.5, SW4.1, SW4.3, SW8.1, SW8.3, SW12.1, SW12.3
GND: C10.2, C11.2, C12.2, JP1.1
unnamed: D04.C, D14.2, D21.P$2, SW4.2, SW4.4, SW4.5
unnamed: D01.C, D13.1, SW1.2, SW1.4, SW1.5
unnamed: D09.C, D17.1, D25.P$2, SW9.2, SW9.4, SW9.5
unnamed: D10.C, D17.2, D26.P$2, SW10.2, SW10.4, SW10.5
unnamed: D02.C, D13.2, D19.P$2, SW2.2, SW2.4, SW2.5
unnamed: D11.C, D18.1, D27.P$2, SW11.2, SW11.4, SW11.5
unnamed: D12.C, D18.2, D28.P$2, SW12.2, SW12.4, SW12.5
unnamed: D05.C, D15.1, SW5.2, SW5.4, SW5.5
unnamed: D06.C, D15.2, D22.P$2, SW6.2, SW6.4, SW6.5
unnamed: D07.C, D16.1, D23.P$2, SW7.2, SW7.4, SW7.5
unnamed: D08.C, D16.2, D24.P$2, SW8.2, SW8.4, SW8.5
unnamed: D03.C, D14.1, D20.P$2, SW3.2, SW3.4, SW3.5
