JensGrabner/snc98_Slash-Number-Calculator/Hardware/eagle/6_6_0/snc98_Display_15x7-Seg_1-digit_SC52.brd

## EAGLE design Hardware/eagle/6_6_0/snc98_Display_15x7-Seg_1-digit_SC52.brd (2019-02-03)

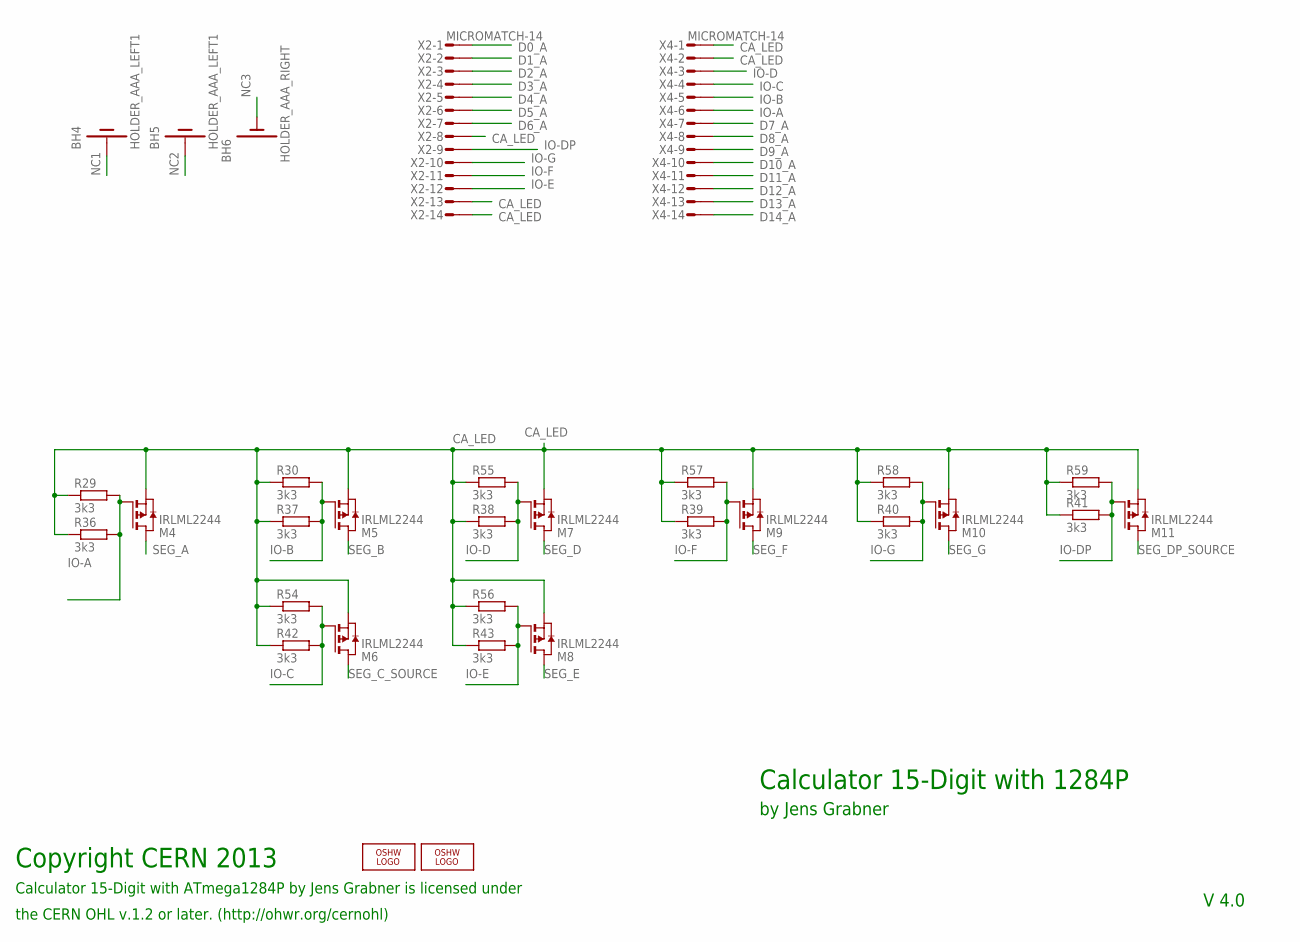
[picture p32: schematic snc98_Display_15x7-Seg_1-digit_SC52.sch, sheet 1]

Parts:
BH4, BH5: HOLDER_AAA_LEFT1; BATTERY-AAA-LEFT
BH6: HOLDER_AAA_RIGHT; BATTERY-AAA-RIGHT
LOGO1: OSHW_LOGO_8MILX0150-NT; OSHW_8X150_NOTEXT
LOGO3: OSHW_LOGO_6MILX0100-NT; OSHW_6X100_NOTEXT
M4, M5, M6, M7, M8, M9, M10, M11: IRLML2244; SOT-23
R29, R30, R54, R55, R56, R57, R58, R59: 3k3; 0204/5
R36, R37, R38, R39, R40, R41, R42, R43: 3k3; R1206
X2, X4: MICROMATCH-14

Connections:
CA_LED: M4.2 (S), M5.2 (S), M6.2 (S), M7.2 (S), M8.2 (S), M9.2 (S), M10.2 (S), M11.2 (S), R29.1, R30.1, R36.1, R37.1, R38.1, R39.1, R40.1, R41.1, R42.1, R43.1, R54.1, R55.1, R56.1, R57.1, R58.1, R59.1, X2.8, X2.13, X2.14, X4.1, X4.2; also elsewhere on the board
D0_A: X2.1; also elsewhere on the board
D1_A: X2.2; also elsewhere on the board
D2_A: X2.3; also elsewhere on the board
D3_A: X2.4; also elsewhere on the board
D4_A: X2.5; also elsewhere on the board
D5_A: X2.6; also elsewhere on the board
D6_A: X2.7; also elsewhere on the board
D7_A: X4.7; also elsewhere on the board
D8_A: X4.8; also elsewhere on the board
D9_A: X4.9; also elsewhere on the board
D10_A: X4.10; also elsewhere on the board
D11_A: X4.11; also elsewhere on the board
D12_A: X4.12; also elsewhere on the board
D13_A: X4.13; also elsewhere on the board
D14_A: X4.14; also elsewhere on the board
IO-A: M4.1 (G), R29.2, R36.2, X4.6; also elsewhere on the board
IO-B: M5.1 (G), R30.2, R37.2, X4.5; also elsewhere on the board
IO-C: M6.1 (G), R42.2, R54.2, X4.4; also elsewhere on the board
IO-D: M7.1 (G), R38.2, R55.2, X4.3; also elsewhere on the board
IO-DP: M11.1 (G), R41.2, R59.2, X2.9; also elsewhere on the board
IO-E: M8.1 (G), R43.2, R56.2, X2.12; also elsewhere on the board
IO-F: M9.1 (G), R39.2, R57.2, X2.11; also elsewhere on the board
IO-G: M10.1 (G), R40.2, R58.2, X2.10; also elsewhere on the board
NC1: BH4.P1, BH4.P2, BH4.P3, BH4.P4
NC2: BH5.P1, BH5.P2, BH5.P3, BH5.P4
NC3: BH6.M1, BH6.M2, BH6.M3, BH6.M4
SEG_A: M4.3 (D); also elsewhere on the board
SEG_B: M5.3 (D); also elsewhere on the board
SEG_C_SOURCE: M6.3 (D); also elsewhere on the board
SEG_D: M7.3 (D); also elsewhere on the board
SEG_DP_SOURCE: M11.3 (D); also elsewhere on the board
SEG_E: M8.3 (D); also elsewhere on the board
SEG_F: M9.3 (D); also elsewhere on the board
SEG_G: M10.3 (D); also elsewhere on the board

Notes on the sheet:
Calculator 15-Digit with 1284P
by Jens Grabner
V 4.0
Calculator 15-Digit with ATmega1284P by Jens Grabner is licensed under
Copyright CERN 2013
the CERN OHL v.1.2 or later. (http://ohwr.org/cernohl)

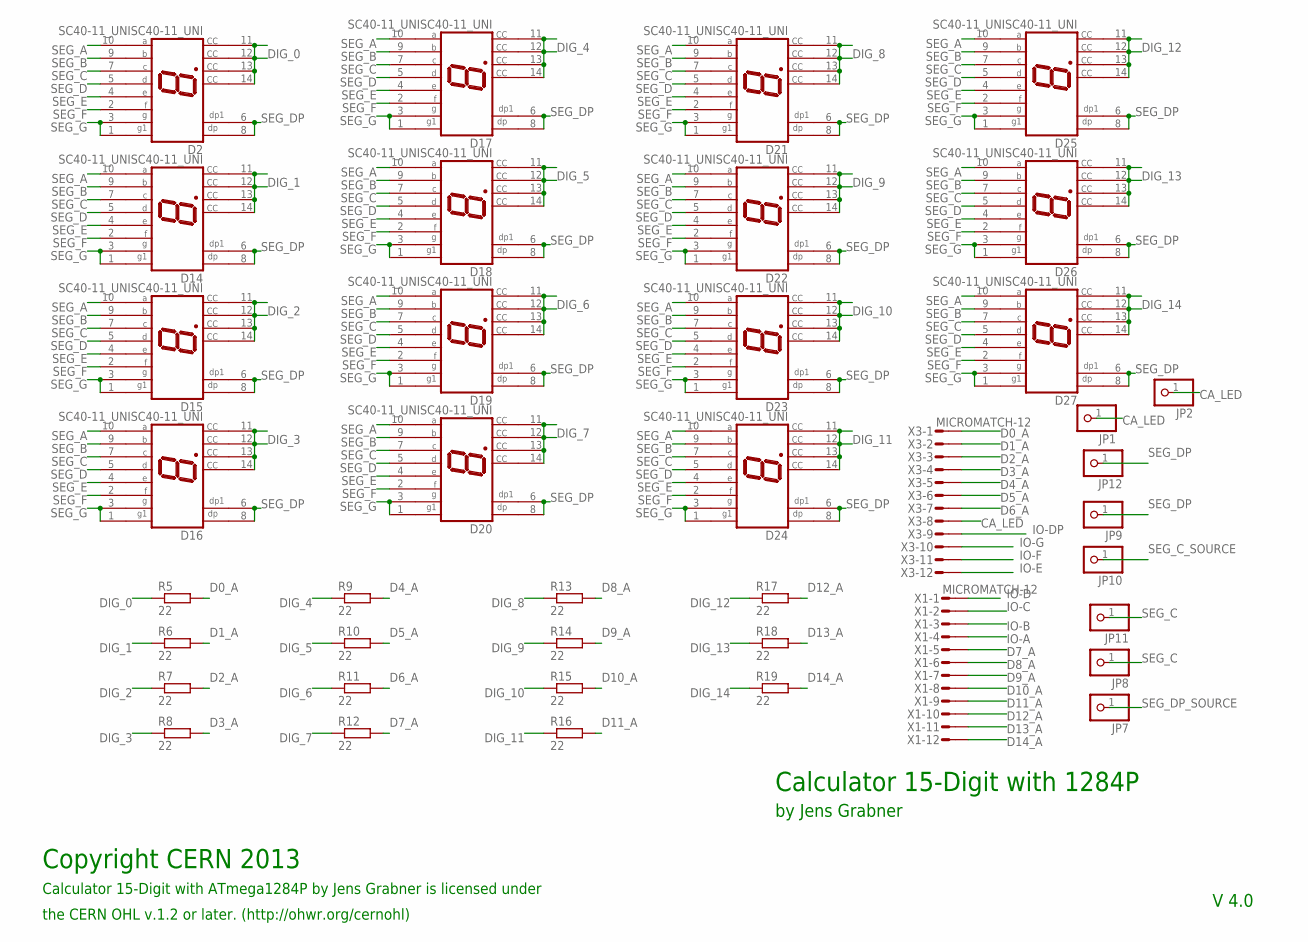
[picture p33: schematic snc98_Display_15x7-Seg_1-digit_SC52.sch, sheet 2]

Parts:
D2, D14, D15, D16, D17, D18, D19, D20, D21, D22, D23, D24, D25, D26, D27: SC40-11_UNISC40-11_UNI; 10MM_UNI
JP1, JP2, JP7, JP8, JP9, JP10, JP11, JP12: PINHD-1X1; 1X01
R5, R6, R7, R8, R9, R10, R11, R12, R13, R14, R15, R16, R17, R18, R19: 22; R1210
X1, X3: MICROMATCH-12

Connections:
CA_LED: JP1.1, JP2.1, X3.8; also elsewhere on the board
D0_A: R5.2, X3.1; also elsewhere on the board
D1_A: R6.2, X3.2; also elsewhere on the board
D2_A: R7.2, X3.3; also elsewhere on the board
D3_A: R8.2, X3.4; also elsewhere on the board
D4_A: R9.2, X3.5; also elsewhere on the board
D5_A: R10.2, X3.6; also elsewhere on the board
D6_A: R11.2, X3.7; also elsewhere on the board
D7_A: R12.2, X1.5; also elsewhere on the board
D8_A: R13.2, X1.6; also elsewhere on the board
D9_A: R14.2, X1.7; also elsewhere on the board
D10_A: R15.2, X1.8; also elsewhere on the board
D11_A: R16.2, X1.9; also elsewhere on the board
D12_A: R17.2, X1.10; also elsewhere on the board
D13_A: R18.2, X1.11; also elsewhere on the board
D14_A: R19.2, X1.12; also elsewhere on the board
DIG_0: D2.11 (CC1), D2.12 (CC2), D2.13 (CC3), D2.14 (CC4), R5.1; also elsewhere on the board
DIG_1: D14.11 (CC1), D14.12 (CC2), D14.13 (CC3), D14.14 (CC4), R6.1; also elsewhere on the board
DIG_2: D15.11 (CC1), D15.12 (CC2), D15.13 (CC3), D15.14 (CC4), R7.1; also elsewhere on the board
DIG_3: D16.11 (CC1), D16.12 (CC2), D16.13 (CC3), D16.14 (CC4), R8.1; also elsewhere on the board
DIG_4: D17.11 (CC1), D17.12 (CC2), D17.13 (CC3), D17.14 (CC4), R9.1; also elsewhere on the board
DIG_5: D18.11 (CC1), D18.12 (CC2), D18.13 (CC3), D18.14 (CC4), R10.1; also elsewhere on the board
DIG_6: D19.11 (CC1), D19.12 (CC2), D19.13 (CC3), D19.14 (CC4), R11.1; also elsewhere on the board
DIG_7: D20.11 (CC1), D20.12 (CC2), D20.13 (CC3), D20.14 (CC4), R12.1; also elsewhere on the board
DIG_8: D21.11 (CC1), D21.12 (CC2), D21.13 (CC3), D21.14 (CC4), R13.1; also elsewhere on the board
DIG_9: D22.11 (CC1), D22.12 (CC2), D22.13 (CC3), D22.14 (CC4), R14.1; also elsewhere on the board
DIG_10: D23.11 (CC1), D23.12 (CC2), D23.13 (CC3), D23.14 (CC4), R15.1; also elsewhere on the board
DIG_11: D24.11 (CC1), D24.12 (CC2), D24.13 (CC3), D24.14 (CC4), R16.1; also elsewhere on the board
DIG_12: D25.11 (CC1), D25.12 (CC2), D25.13 (CC3), D25.14 (CC4), R17.1; also elsewhere on the board
DIG_13: D26.11 (CC1), D26.12 (CC2), D26.13 (CC3), D26.14 (CC4), R18.1; also elsewhere on the board
DIG_14: D27.11 (CC1), D27.12 (CC2), D27.13 (CC3), D27.14 (CC4), R19.1; also elsewhere on the board
IO-A: X1.4; also elsewhere on the board
IO-B: X1.3; also elsewhere on the board
IO-C: X1.2; also elsewhere on the board
IO-D: X1.1; also elsewhere on the board
IO-DP: X3.9; also elsewhere on the board
IO-E: X3.12; also elsewhere on the board
IO-F: X3.11; also elsewhere on the board
IO-G: X3.10; also elsewhere on the board
SEG_A: D2.10 (A), D14.10 (A), D15.10 (A), D16.10 (A), D17.10 (A), D18.10 (A), D19.10 (A), D20.10 (A), D21.10 (A), D22.10 (A), D23.10 (A), D24.10 (A), D25.10 (A), D26.10 (A), D27.10 (A); also elsewhere on the board
SEG_B: D2.9 (B), D14.9 (B), D15.9 (B), D16.9 (B), D17.9 (B), D18.9 (B), D19.9 (B), D20.9 (B), D21.9 (B), D22.9 (B), D23.9 (B), D24.9 (B), D25.9 (B), D26.9 (B), D27.9 (B); also elsewhere on the board
SEG_C: D2.7 (C), D14.7 (C), D15.7 (C), D16.7 (C), D17.7 (C), D18.7 (C), D19.7 (C), D20.7 (C), D21.7 (C), D22.7 (C), D23.7 (C), D24.7 (C), D25.7 (C), D26.7 (C), D27.7 (C), JP8.1, JP11.1; also elsewhere on the board
SEG_C_SOURCE: JP10.1; also elsewhere on the board
SEG_D: D2.5 (D), D14.5 (D), D15.5 (D), D16.5 (D), D17.5 (D), D18.5 (D), D19.5 (D), D20.5 (D), D21.5 (D), D22.5 (D), D23.5 (D), D24.5 (D), D25.5 (D), D26.5 (D), D27.5 (D); also elsewhere on the board
SEG_DP: D2.6 (DP1), D2.8 (DP), D14.6 (DP1), D14.8 (DP), D15.6 (DP1), D15.8 (DP), D16.6 (DP1), D16.8 (DP), D17.6 (DP1), D17.8 (DP), D18.6 (DP1), D18.8 (DP), D19.6 (DP1), D19.8 (DP), D20.6 (DP1), D20.8 (DP), D21.6 (DP1), D21.8 (DP), D22.6 (DP1), D22.8 (DP), D23.6 (DP1), D23.8 (DP), D24.6 (DP1), D24.8 (DP), D25.6 (DP1), D25.8 (DP), D26.6 (DP1), D26.8 (DP), D27.6 (DP1), D27.8 (DP), JP9.1, JP12.1; also elsewhere on the board
SEG_DP_SOURCE: JP7.1; also elsewhere on the board
SEG_E: D2.4 (E), D14.4 (E), D15.4 (E), D16.4 (E), D17.4 (E), D18.4 (E), D19.4 (E), D20.4 (E), D21.4 (E), D22.4 (E), D23.4 (E), D24.4 (E), D25.4 (E), D26.4 (E), D27.4 (E); also elsewhere on the board
SEG_F: D2.2 (F), D14.2 (F), D15.2 (F), D16.2 (F), D17.2 (F), D18.2 (F), D19.2 (F), D20.2 (F), D21.2 (F), D22.2 (F), D23.2 (F), D24.2 (F), D25.2 (F), D26.2 (F), D27.2 (F); also elsewhere on the board
SEG_G: D2.1 (G1), D2.3 (G), D14.1 (G1), D14.3 (G), D15.1 (G1), D15.3 (G), D16.1 (G1), D16.3 (G), D17.1 (G1), D17.3 (G), D18.1 (G1), D18.3 (G), D19.1 (G1), D19.3 (G), D20.1 (G1), D20.3 (G), D21.1 (G1), D21.3 (G), D22.1 (G1), D22.3 (G), D23.1 (G1), D23.3 (G), D24.1 (G1), D24.3 (G), D25.1 (G1), D25.3 (G), D26.1 (G1), D26.3 (G), D27.1 (G1), D27.3 (G); also elsewhere on the board

Notes on the sheet:
Calculator 15-Digit with 1284P
by Jens Grabner
V 4.0
Calculator 15-Digit with ATmega1284P by Jens Grabner is licensed under
Copyright CERN 2013
the CERN OHL v.1.2 or later. (http://ohwr.org/cernohl)
