JensGrabner/snc98_Slash-Number-Calculator/Hardware/eagle/6_6_0/snc98_Display_15x7-Seg_1-digit_SC52.brd

## EAGLE design Hardware/eagle/6_6_0/snc98_Display_15x7-Seg_1-digit_SC52.brd (continued)

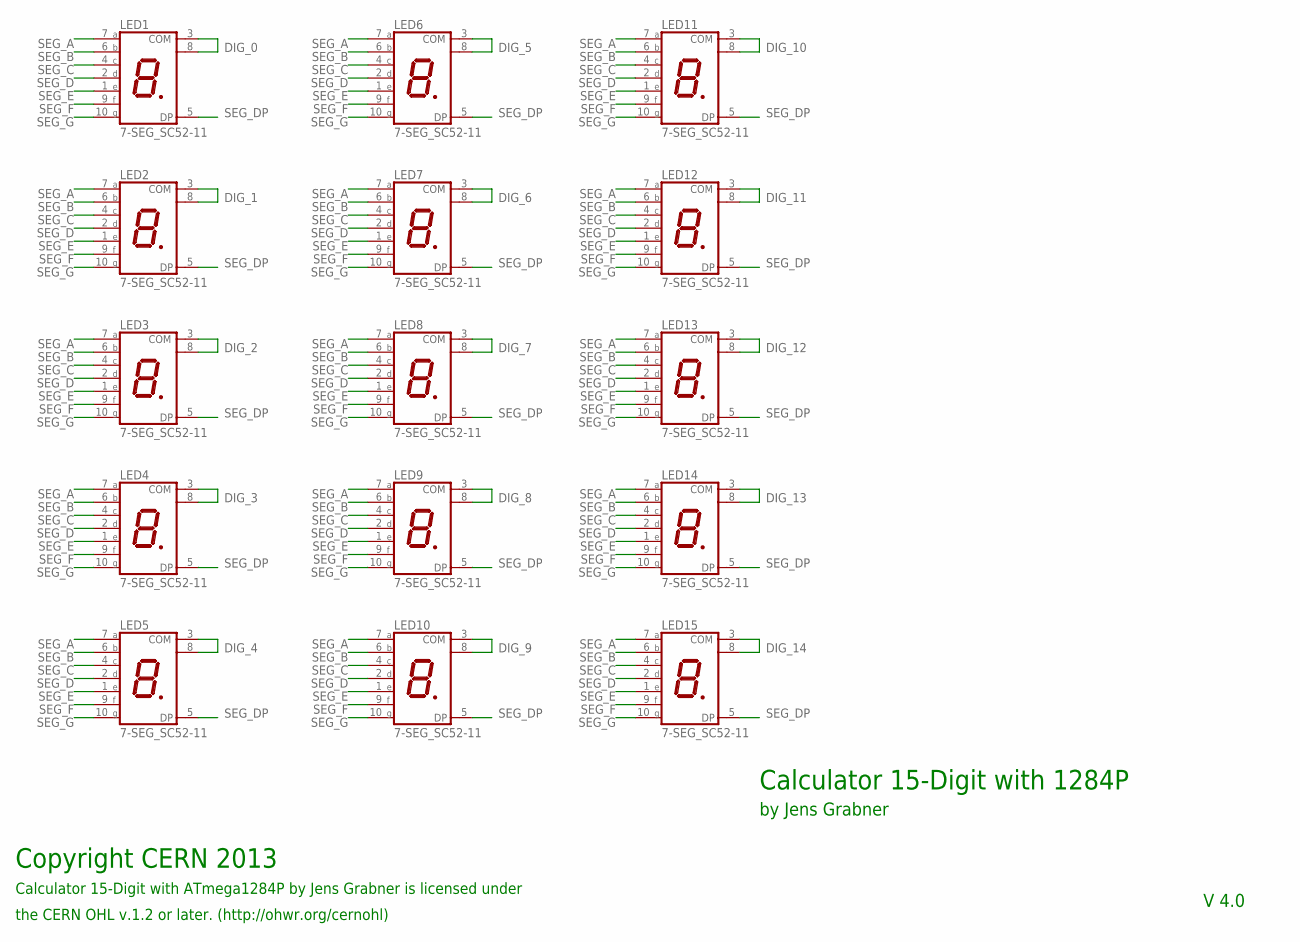
[picture p34: schematic snc98_Display_15x7-Seg_1-digit_SC52.sch, sheet 3]

Parts:
LED1, LED2, LED3, LED4, LED5, LED6, LED7, LED8, LED9, LED10, LED11, LED12, LED13, LED14, LED15: 7-SEG_SC52-11; SA52-11

Connections:
DIG_0: LED1.3 (COM), LED1.8 (COM); also elsewhere on the board
DIG_1: LED2.3 (COM), LED2.8 (COM); also elsewhere on the board
DIG_2: LED3.3 (COM), LED3.8 (COM); also elsewhere on the board
DIG_3: LED4.3 (COM), LED4.8 (COM); also elsewhere on the board
DIG_4: LED5.3 (COM), LED5.8 (COM); also elsewhere on the board
DIG_5: LED6.3 (COM), LED6.8 (COM); also elsewhere on the board
DIG_6: LED7.3 (COM), LED7.8 (COM); also elsewhere on the board
DIG_7: LED8.3 (COM), LED8.8 (COM); also elsewhere on the board
DIG_8: LED9.3 (COM), LED9.8 (COM); also elsewhere on the board
DIG_9: LED10.3 (COM), LED10.8 (COM); also elsewhere on the board
DIG_10: LED11.3 (COM), LED11.8 (COM); also elsewhere on the board
DIG_11: LED12.3 (COM), LED12.8 (COM); also elsewhere on the board
DIG_12: LED13.3 (COM), LED13.8 (COM); also elsewhere on the board
DIG_13: LED14.3 (COM), LED14.8 (COM); also elsewhere on the board
DIG_14: LED15.3 (COM), LED15.8 (COM); also elsewhere on the board
SEG_A: LED1.7 (A), LED2.7 (A), LED3.7 (A), LED4.7 (A), LED5.7 (A), LED6.7 (A), LED7.7 (A), LED8.7 (A), LED9.7 (A), LED10.7 (A), LED11.7 (A), LED12.7 (A), LED13.7 (A), LED14.7 (A), LED15.7 (A); also elsewhere on the board
SEG_B: LED1.6 (B), LED2.6 (B), LED3.6 (B), LED4.6 (B), LED5.6 (B), LED6.6 (B), LED7.6 (B), LED8.6 (B), LED9.6 (B), LED10.6 (B), LED11.6 (B), LED12.6 (B), LED13.6 (B), LED14.6 (B), LED15.6 (B); also elsewhere on the board
SEG_C: LED1.4 (C), LED2.4 (C), LED3.4 (C), LED4.4 (C), LED5.4 (C), LED6.4 (C), LED7.4 (C), LED8.4 (C), LED9.4 (C), LED10.4 (C), LED11.4 (C), LED12.4 (C), LED13.4 (C), LED14.4 (C), LED15.4 (C); also elsewhere on the board
SEG_D: LED1.2 (D), LED2.2 (D), LED3.2 (D), LED4.2 (D), LED5.2 (D), LED6.2 (D), LED7.2 (D), LED8.2 (D), LED9.2 (D), LED10.2 (D), LED11.2 (D), LED12.2 (D), LED13.2 (D), LED14.2 (D), LED15.2 (D); also elsewhere on the board
SEG_DP: LED1.5 (DP), LED2.5 (DP), LED3.5 (DP), LED4.5 (DP), LED5.5 (DP), LED6.5 (DP), LED7.5 (DP), LED8.5 (DP), LED9.5 (DP), LED10.5 (DP), LED11.5 (DP), LED12.5 (DP), LED13.5 (DP), LED14.5 (DP), LED15.5 (DP); also elsewhere on the board
SEG_E: LED1.1 (E), LED2.1 (E), LED3.1 (E), LED4.1 (E), LED5.1 (E), LED6.1 (E), LED7.1 (E), LED8.1 (E), LED9.1 (E), LED10.1 (E), LED11.1 (E), LED12.1 (E), LED13.1 (E), LED14.1 (E), LED15.1 (E); also elsewhere on the board
SEG_F: LED1.9 (F), LED2.9 (F), LED3.9 (F), LED4.9 (F), LED5.9 (F), LED6.9 (F), LED7.9 (F), LED8.9 (F), LED9.9 (F), LED10.9 (F), LED11.9 (F), LED12.9 (F), LED13.9 (F), LED14.9 (F), LED15.9 (F); also elsewhere on the board
SEG_G: LED1.10 (G), LED2.10 (G), LED3.10 (G), LED4.10 (G), LED5.10 (G), LED6.10 (G), LED7.10 (G), LED8.10 (G), LED9.10 (G), LED10.10 (G), LED11.10 (G), LED12.10 (G), LED13.10 (G), LED14.10 (G), LED15.10 (G); also elsewhere on the board

Notes on the sheet:
Calculator 15-Digit with 1284P
by Jens Grabner
V 4.0
Calculator 15-Digit with ATmega1284P by Jens Grabner is licensed under
Copyright CERN 2013
the CERN OHL v.1.2 or later. (http://ohwr.org/cernohl)

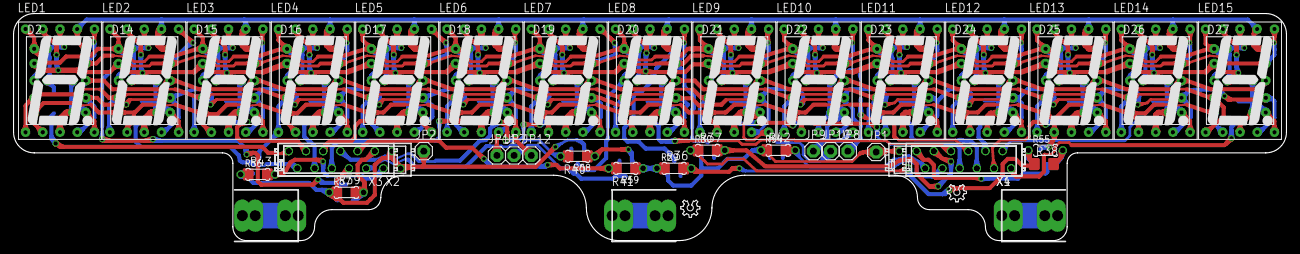
[picture p35: board snc98_Display_15x7-Seg_1-digit_SC52.brd from above]

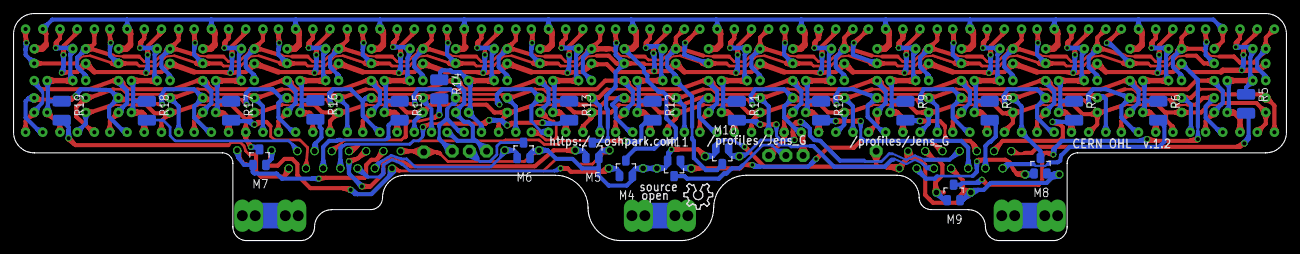
[picture p36: board snc98_Display_15x7-Seg_1-digit_SC52.brd from below]

Board: 2 copper layers, 188.0 x 33.5 mm, 87 parts (24 on the bottom side), 52 nets.

Other parts of the board:
LOGO2: OSHW_LOGO_6MILX0100-NT; OSHW_6X100_NOTEXT
