JensGrabner/snc98_Slash-Number-Calculator/Hardware/eagle/6_6_0/snc98_3x4_Switch-cherry_ml.brd

## EAGLE design Hardware/eagle/6_6_0/snc98_3x4_Switch-cherry_ml.brd (2021-11-27)

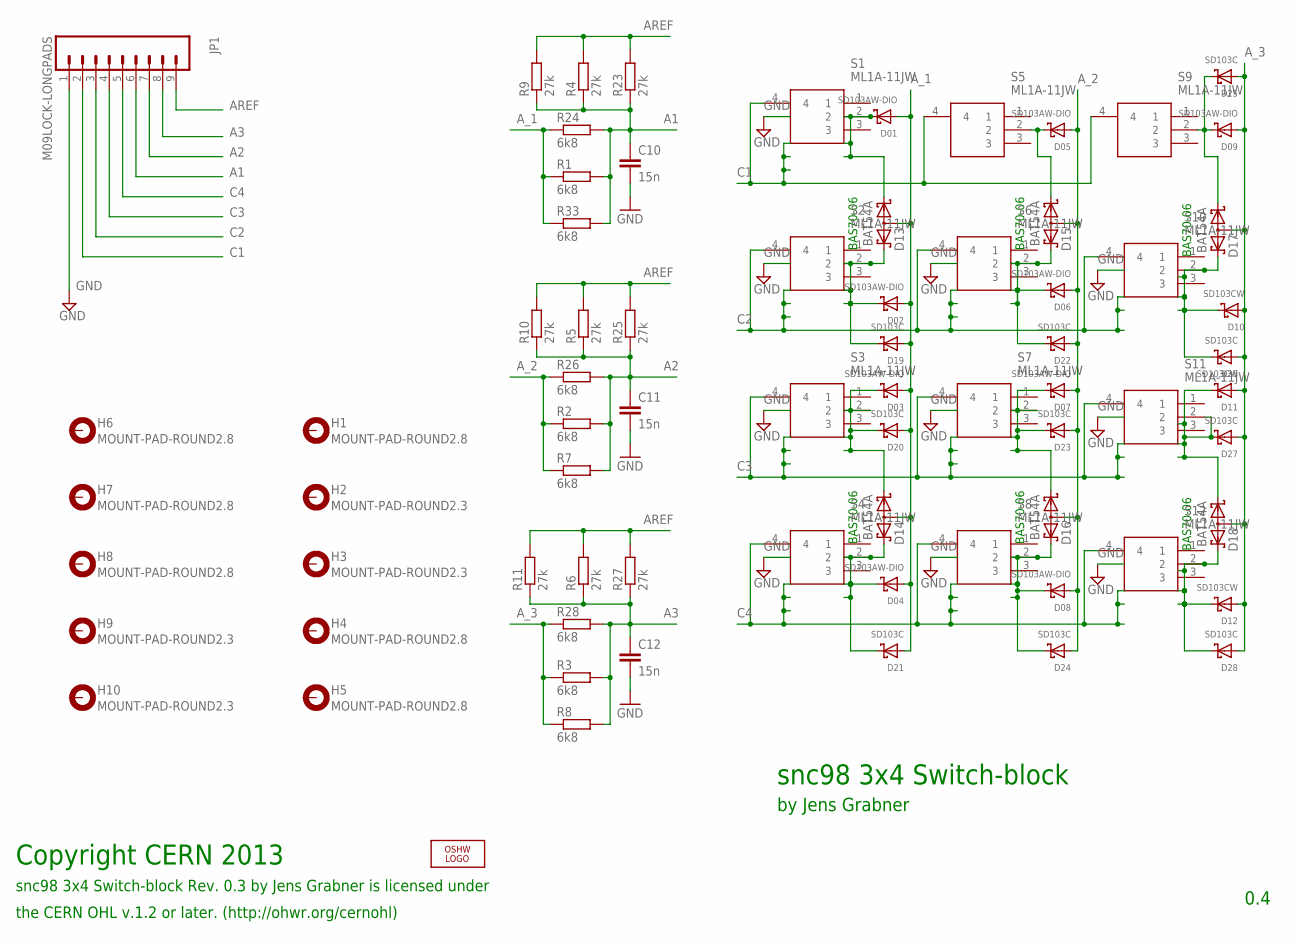
[picture p37: schematic snc98_3x4_Switch-cherry_ml.sch]

Parts:
C10, C11, C12: 15n; C1206K
D01, D02, D03, D04, D05, D06, D07, D08, D09: SD103AW-DIO; SOD-123F; MPN SD103CW-7-F
D10, D11, D12: SD103CW; SOD-123F; MPN SD103CW-7-F
D13, D14, D15, D16, D17, D18: BAT54A; SOT23
D19, D20, D21, D22, D23, D24, D25, D26, D27, D28: SD103C; 280MIL-TH; MPN SD103CW-7-F
H1, H4, H5, H6, H7, H8: MOUNT-PAD-ROUND2.8; 2,8-PAD
H2, H3, H9, H10: MOUNT-PAD-ROUND2.3; 2,3-PAD
JP1: M09LOCK-LONGPADS; 1X09_LOCK_LONGPADS
LOGO1: OSHW_LOGO_8MILX0150-NT; OSHW_8X150_NOTEXT
R1, R2, R3: 6k8; R1206
R4, R5, R6: 27k; R1206
R7, R8, R33: 6k8; M0805
R9, R10, R11: 27k; M0805
R23, R25, R27: 27k; 0204/5
R24, R26, R28: 6k8; 0204/5
S1, S2, S3, S4, S5, S6, S7, S8, S9, S10, S11, S12: ML1A-11JW; ML1A11JW

Connections:
A1: C10.1, JP1.6, R1.2, R4.1, R9.1, R23.1, R24.2, R33.2
A2: C11.1, JP1.7, R2.2, R5.1, R7.2, R10.1, R25.1, R26.2
A3: C12.1, JP1.8, R3.2, R6.1, R8.2, R11.1, R27.1, R28.2
AREF: JP1.9, R4.2, R5.2, R6.2, R9.2, R10.2, R11.2, R23.2, R25.2, R27.2
A_1: D01.A, D02.A, D03.A, D04.A, D13.3 (AA), D14.3 (AA), D19.P$1 (A), D20.P$1 (A), D21.P$1 (A), R1.1, R24.1, R33.1
A_2: D05.A, D06.A, D07.A, D08.A, D15.3 (AA), D16.3 (AA), D22.P$1 (A), D23.P$1 (A), D24.P$1 (A), R2.1, R7.1, R26.1
A_3: D09.A, D10.A, D11.A, D12.A, D17.3 (AA), D18.3 (AA), D25.P$1 (A), D26.P$1 (A), D27.P$1 (A), D28.P$1 (A), R3.1, R8.1, R28.1
C1: JP1.2, S1.4, S5.4, S9.4
C2: JP1.3, S2.4, S6.4, S10.4
C3: JP1.4, S3.4, S7.4, S11.4
C4: JP1.5, S4.4, S8.4, S12.4
GND: C10.2, C11.2, C12.2, JP1.1
unnamed: D04.C, D14.2 (K2), D21.P$2 (C), S4.2
unnamed: D01.C, D13.1 (K1), S1.2
unnamed: D05.C, D15.1 (K1), S5.2
unnamed: D09.C, D17.1 (K1), D25.P$2 (C), S9.2
unnamed: D10.C, D17.2 (K2), D26.P$2 (C), S10.2
unnamed: D02.C, D13.2 (K2), D19.P$2 (C), S2.2
unnamed: D11.C, D18.1 (K1), D27.P$2 (C), S11.2
unnamed: D12.C, D18.2 (K2), D28.P$2 (C), S12.2
unnamed: D06.C, D15.2 (K2), D22.P$2 (C), S6.2
unnamed: D07.C, D16.1 (K1), D23.P$2 (C), S7.2
unnamed: D08.C, D16.2 (K2), D24.P$2 (C), S8.2
unnamed: D03.C, D14.1 (K1), D20.P$2 (C), S3.2

Notes on the sheet:
snc98 3x4 Switch-block
by Jens Grabner
0.4
snc98 3x4 Switch-block Rev. 0.3 by Jens Grabner is licensed under
Copyright CERN 2013
the CERN OHL v.1.2 or later. (http://ohwr.org/cernohl)
BAS70-06

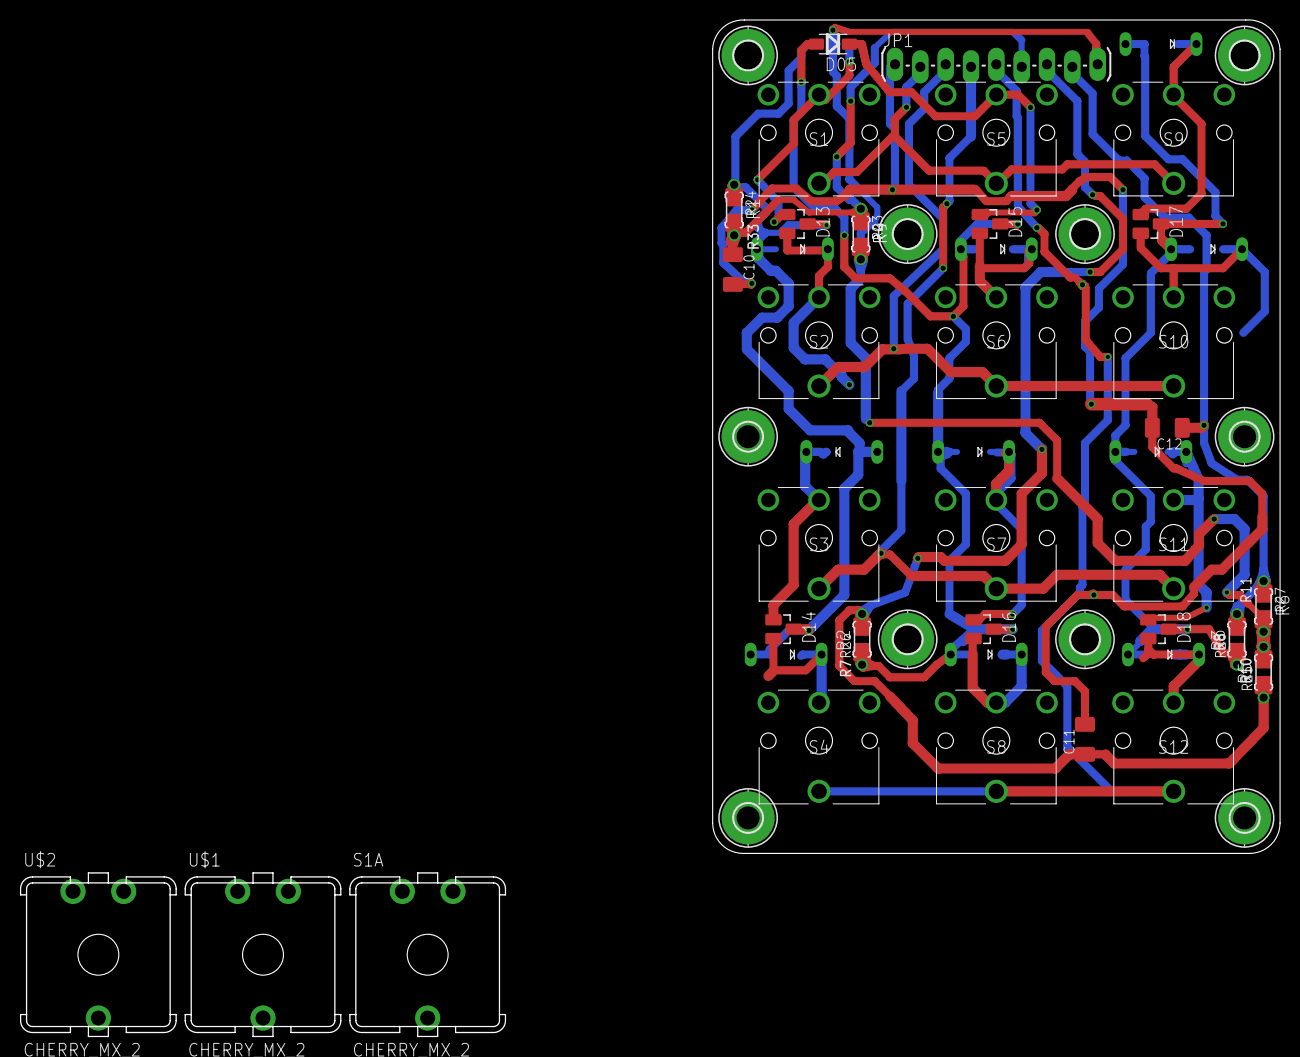
[picture p38: board snc98_3x4_Switch-cherry_ml.brd from above]

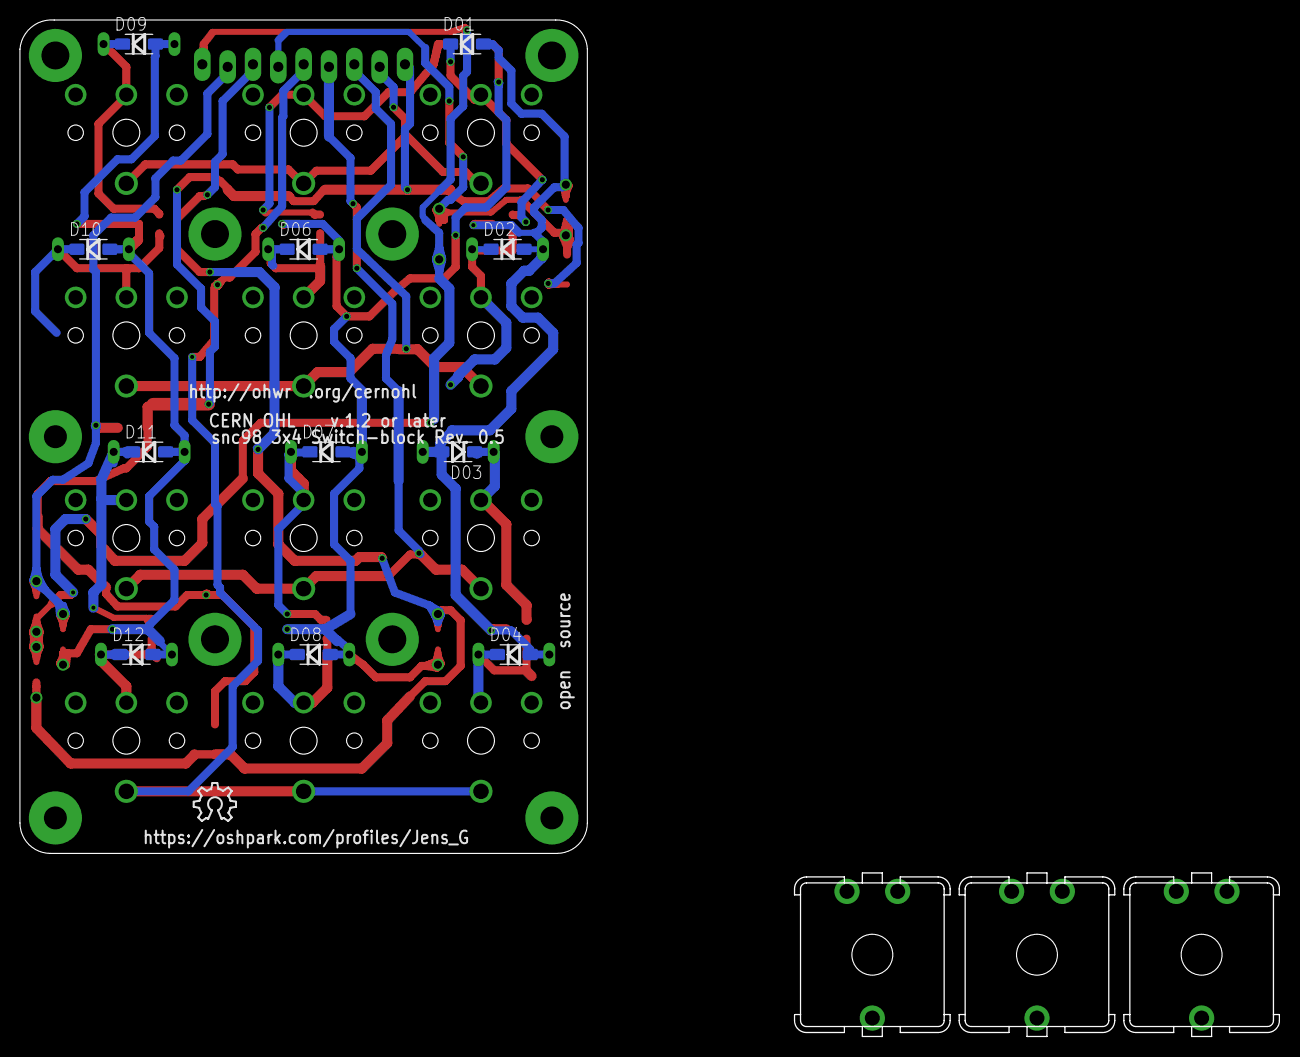
[picture p39: board snc98_3x4_Switch-cherry_ml.brd from below]

Board: 2 copper layers, 56.9 x 83.6 mm, 76 parts (12 on the bottom side), 24 nets.

Other parts of the board:
S1A: CHERRY_MX_2; CHERRY_MX
U$1, U$2: CHERRY_MX_2; CHERRY_MX
