JensGrabner/snc98_Slash-Number-Calculator/Hardware/eagle/6_6_0/snc98_Display_15x7-Seg_3-digit_LTD056.brd

## EAGLE design Hardware/eagle/6_6_0/snc98_Display_15x7-Seg_3-digit_LTD056.brd (2020-03-26)

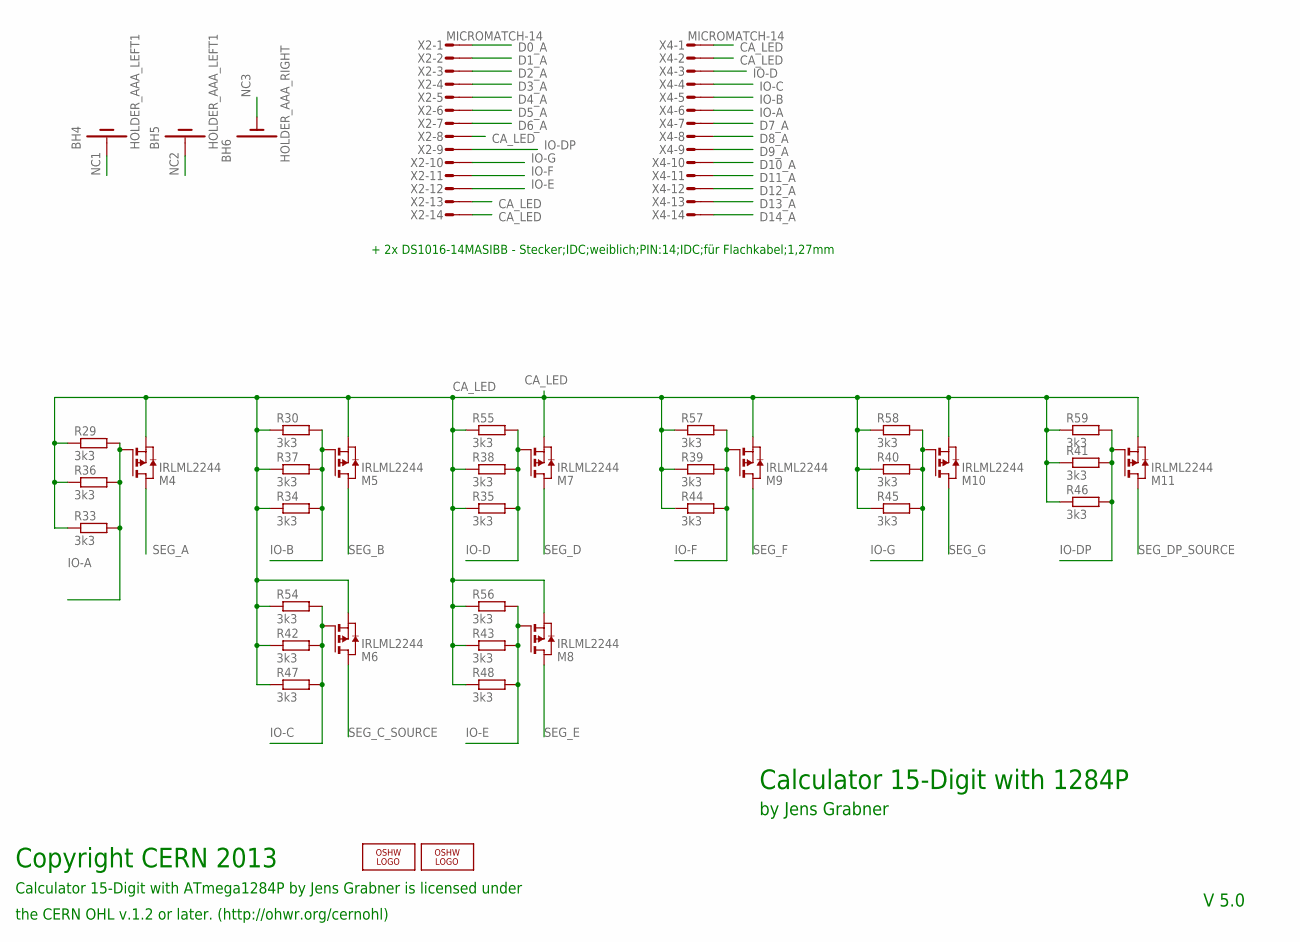
[picture p40: schematic snc98_Display_15x7-Seg_3-digit_LTD056.sch, sheet 1]

Parts:
BH4, BH5: HOLDER_AAA_LEFT1; BATTERY-AAA-LEFT
BH6: HOLDER_AAA_RIGHT; BATTERY-AAA-RIGHT
LOGO1: OSHW_LOGO_8MILX0150-NT; OSHW_8X150_NOTEXT
LOGO3: OSHW_LOGO_6MILX0100-NT; OSHW_6X100_NOTEXT
M4, M5, M6, M7, M8, M9, M10, M11: IRLML2244; SOT-23; MPN IRLML2244TRPBF
R29, R30, R54, R55, R56, R57, R58, R59: 3k3; 0204/5
R33, R34, R35, R44, R45, R46, R47, R48: 3k3; M0805
R36, R37, R38, R39, R40, R41, R42, R43: 3k3; R1206
X2, X4: MICROMATCH-14

Connections:
CA_LED: M4.2 (S), M5.2 (S), M6.2 (S), M7.2 (S), M8.2 (S), M9.2 (S), M10.2 (S), M11.2 (S), R29.1, R30.1, R33.1, R34.1, R35.1, R36.1, R37.1, R38.1, R39.1, R40.1, R41.1, R42.1, R43.1, R44.1, R45.1, R46.1, R47.1, R48.1, R54.1, R55.1, R56.1, R57.1, R58.1, R59.1, X2.8, X2.13, X2.14, X4.1, X4.2; also elsewhere on the board
D0_A: X2.1; also elsewhere on the board
D1_A: X2.2; also elsewhere on the board
D2_A: X2.3; also elsewhere on the board
D3_A: X2.4; also elsewhere on the board
D4_A: X2.5; also elsewhere on the board
D5_A: X2.6; also elsewhere on the board
D6_A: X2.7; also elsewhere on the board
D7_A: X4.7; also elsewhere on the board
D8_A: X4.8; also elsewhere on the board
D9_A: X4.9; also elsewhere on the board
D10_A: X4.10; also elsewhere on the board
D11_A: X4.11; also elsewhere on the board
D12_A: X4.12; also elsewhere on the board
D13_A: X4.13; also elsewhere on the board
D14_A: X4.14; also elsewhere on the board
IO-A: M4.1 (G), R29.2, R33.2, R36.2, X4.6
IO-B: M5.1 (G), R30.2, R34.2, R37.2, X4.5
IO-C: M6.1 (G), R42.2, R47.2, R54.2, X4.4
IO-D: M7.1 (G), R35.2, R38.2, R55.2, X4.3
IO-DP: M11.1 (G), R41.2, R46.2, R59.2, X2.9
IO-E: M8.1 (G), R43.2, R48.2, R56.2, X2.12
IO-F: M9.1 (G), R39.2, R44.2, R57.2, X2.11
IO-G: M10.1 (G), R40.2, R45.2, R58.2, X2.10
NC1: BH4.P1, BH4.P2, BH4.P3, BH4.P4
NC2: BH5.P1, BH5.P2, BH5.P3, BH5.P4
NC3: BH6.M1, BH6.M2, BH6.M3, BH6.M4
SEG_A: M4.3 (D); also elsewhere on the board
SEG_B: M5.3 (D); also elsewhere on the board
SEG_C_SOURCE: M6.3 (D); also elsewhere on the board
SEG_D: M7.3 (D); also elsewhere on the board
SEG_DP_SOURCE: M11.3 (D)
SEG_E: M8.3 (D); also elsewhere on the board
SEG_F: M9.3 (D); also elsewhere on the board
SEG_G: M10.3 (D); also elsewhere on the board

Notes on the sheet:
Calculator 15-Digit with 1284P
by Jens Grabner
V 5.0
Calculator 15-Digit with ATmega1284P by Jens Grabner is licensed under
Copyright CERN 2013
the CERN OHL v.1.2 or later. (http://ohwr.org/cernohl)
+ 2x DS1016-14MASIBB - Stecker;IDC;weiblich;PIN:14;IDC;für Flachkabel;1,27mm

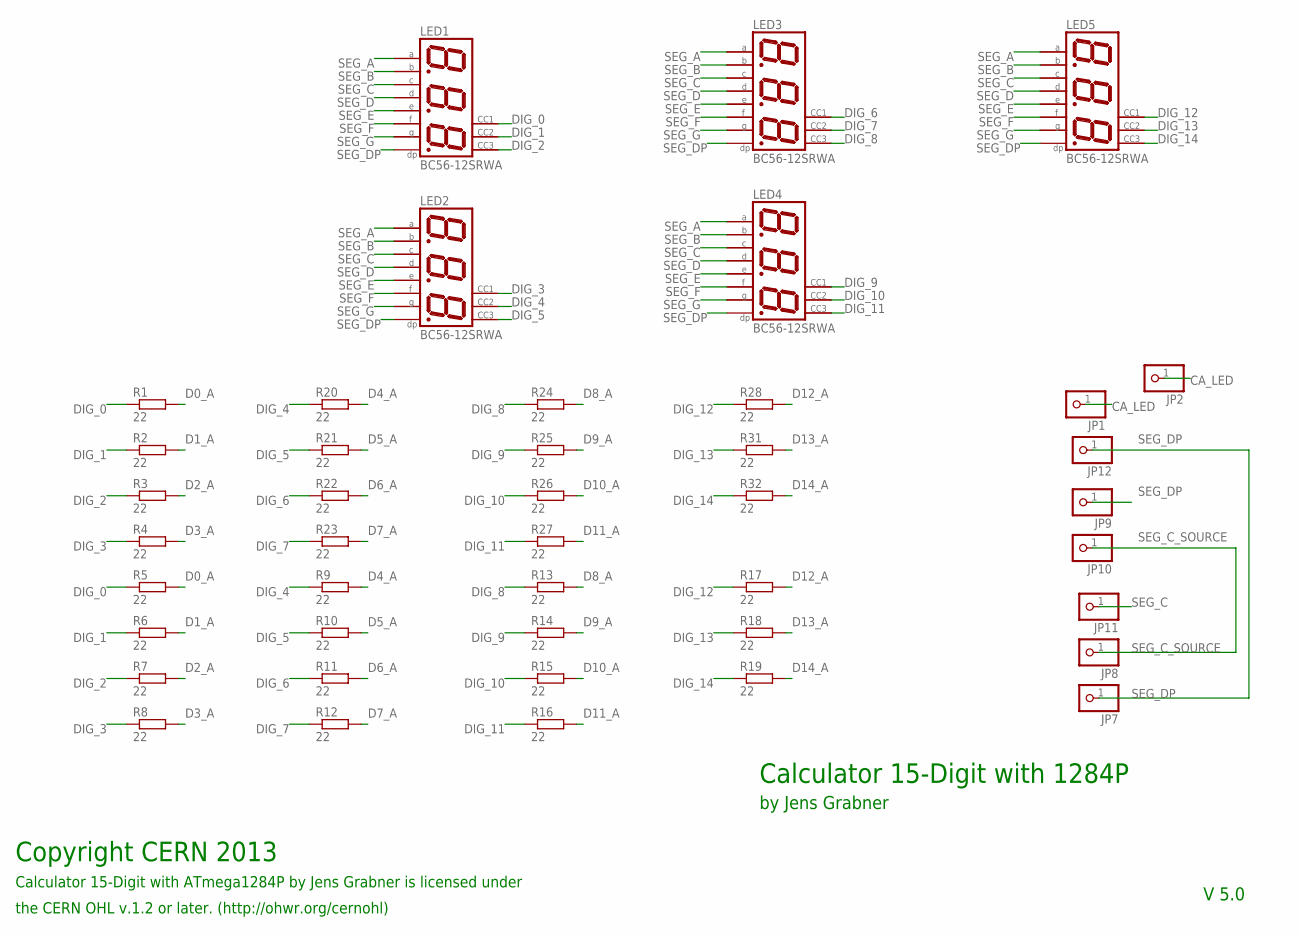
[picture p41: schematic snc98_Display_15x7-Seg_3-digit_LTD056.sch, sheet 2]

Parts:
JP1, JP2, JP7, JP8, JP9, JP10, JP11, JP12: PINHD-1X1; 1X01
LED1, LED2, LED3, LED4, LED5: BC56-12SRWA; BX56-12
R1, R2, R3, R4, R20, R21, R22, R23, R24, R25, R26, R27, R28, R31, R32: 22; R0805
R5, R6, R7, R8, R9, R10, R11, R12, R13, R14, R15, R16, R17, R18, R19: 22; R1210

Connections:
CA_LED: JP1.1, JP2.1; also elsewhere on the board
D0_A: R1.2, R5.2; also elsewhere on the board
D1_A: R2.2, R6.2; also elsewhere on the board
D2_A: R3.2, R7.2; also elsewhere on the board
D3_A: R4.2, R8.2; also elsewhere on the board
D4_A: R9.2, R20.2; also elsewhere on the board
D5_A: R10.2, R21.2; also elsewhere on the board
D6_A: R11.2, R22.2; also elsewhere on the board
D7_A: R12.2, R23.2; also elsewhere on the board
D8_A: R13.2, R24.2; also elsewhere on the board
D9_A: R14.2, R25.2; also elsewhere on the board
D10_A: R15.2, R26.2; also elsewhere on the board
D11_A: R16.2, R27.2; also elsewhere on the board
D12_A: R17.2, R28.2; also elsewhere on the board
D13_A: R18.2, R31.2; also elsewhere on the board
D14_A: R19.2, R32.2; also elsewhere on the board
DIG_0: LED1.12 (CA), R1.1, R5.1
DIG_1: LED1.9 (CA), R2.1, R6.1
DIG_2: LED1.8 (CA), R3.1, R7.1
DIG_3: LED2.12 (CA), R4.1, R8.1
DIG_4: LED2.9 (CA), R9.1, R20.1
DIG_5: LED2.8 (CA), R10.1, R21.1
DIG_6: LED3.12 (CA), R11.1, R22.1
DIG_7: LED3.9 (CA), R12.1, R23.1
DIG_8: LED3.8 (CA), R13.1, R24.1
DIG_9: LED4.12 (CA), R14.1, R25.1
DIG_10: LED4.9 (CA), R15.1, R26.1
DIG_11: LED4.8 (CA), R16.1, R27.1
DIG_12: LED5.12 (CA), R17.1, R28.1
DIG_13: LED5.9 (CA), R18.1, R31.1
DIG_14: LED5.8 (CA), R19.1, R32.1
SEG_A: LED1.11 (A), LED2.11 (A), LED3.11 (A), LED4.11 (A), LED5.11 (A); also elsewhere on the board
SEG_B: LED1.7 (B), LED2.7 (B), LED3.7 (B), LED4.7 (B), LED5.7 (B); also elsewhere on the board
SEG_C: JP11.1, LED1.4 (C), LED2.4 (C), LED3.4 (C), LED4.4 (C), LED5.4 (C)
SEG_C_SOURCE: JP8.1, JP10.1; also elsewhere on the board
SEG_D: LED1.2 (D), LED2.2 (D), LED3.2 (D), LED4.2 (D), LED5.2 (D); also elsewhere on the board
SEG_DP: JP7.1, JP9.1, JP12.1, LED1.3 (DP), LED2.3 (DP), LED3.3 (DP), LED4.3 (DP), LED5.3 (DP)
SEG_E: LED1.1 (E), LED2.1 (E), LED3.1 (E), LED4.1 (E), LED5.1 (E); also elsewhere on the board
SEG_F: LED1.10 (F), LED2.10 (F), LED3.10 (F), LED4.10 (F), LED5.10 (F); also elsewhere on the board
SEG_G: LED1.5 (G), LED2.5 (G), LED3.5 (G), LED4.5 (G), LED5.5 (G); also elsewhere on the board

Notes on the sheet:
Calculator 15-Digit with 1284P
by Jens Grabner
V 5.0
Calculator 15-Digit with ATmega1284P by Jens Grabner is licensed under
Copyright CERN 2013
the CERN OHL v.1.2 or later. (http://ohwr.org/cernohl)

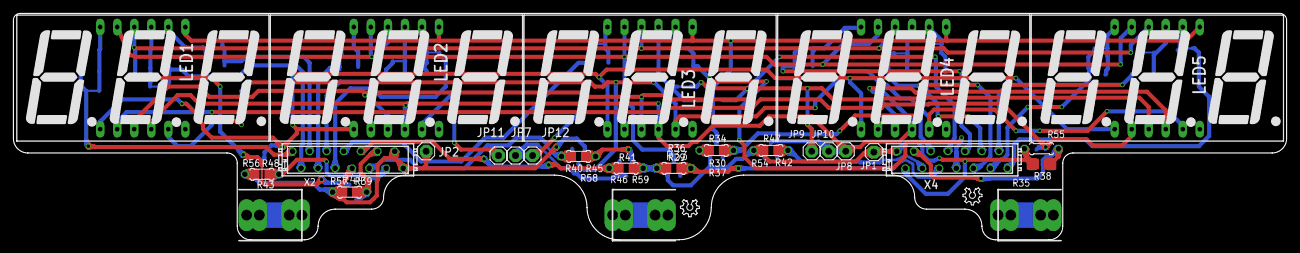
[picture p42: board snc98_Display_15x7-Seg_3-digit_LTD056.brd from above]

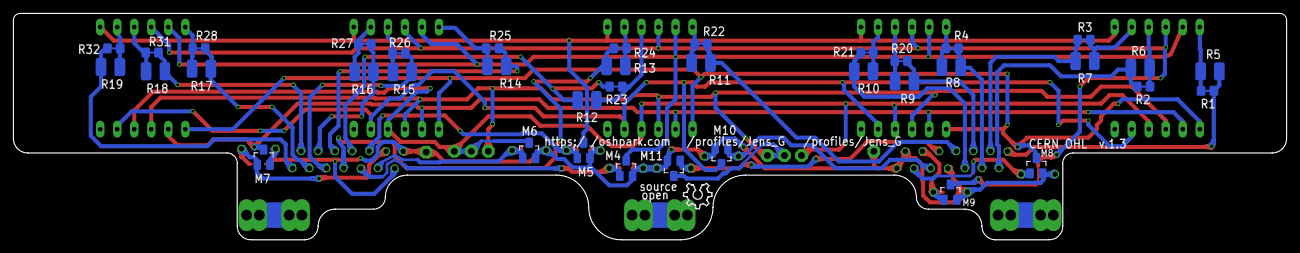
[picture p43: board snc98_Display_15x7-Seg_3-digit_LTD056.brd from below]

Board: 2 copper layers, 190.0 x 33.8 mm, 83 parts (39 on the bottom side), 51 nets.

Other parts of the board:
LOGO2: OSHW_LOGO_6MILX0100-NT; OSHW_6X100_NOTEXT
