JensGrabner/snc98_Slash-Number-Calculator/Hardware/eagle/6_6_0/snc98_3x4_Switch-block.brd

## EAGLE design Hardware/eagle/6_6_0/snc98_3x4_Switch-block.brd (2021-11-27)

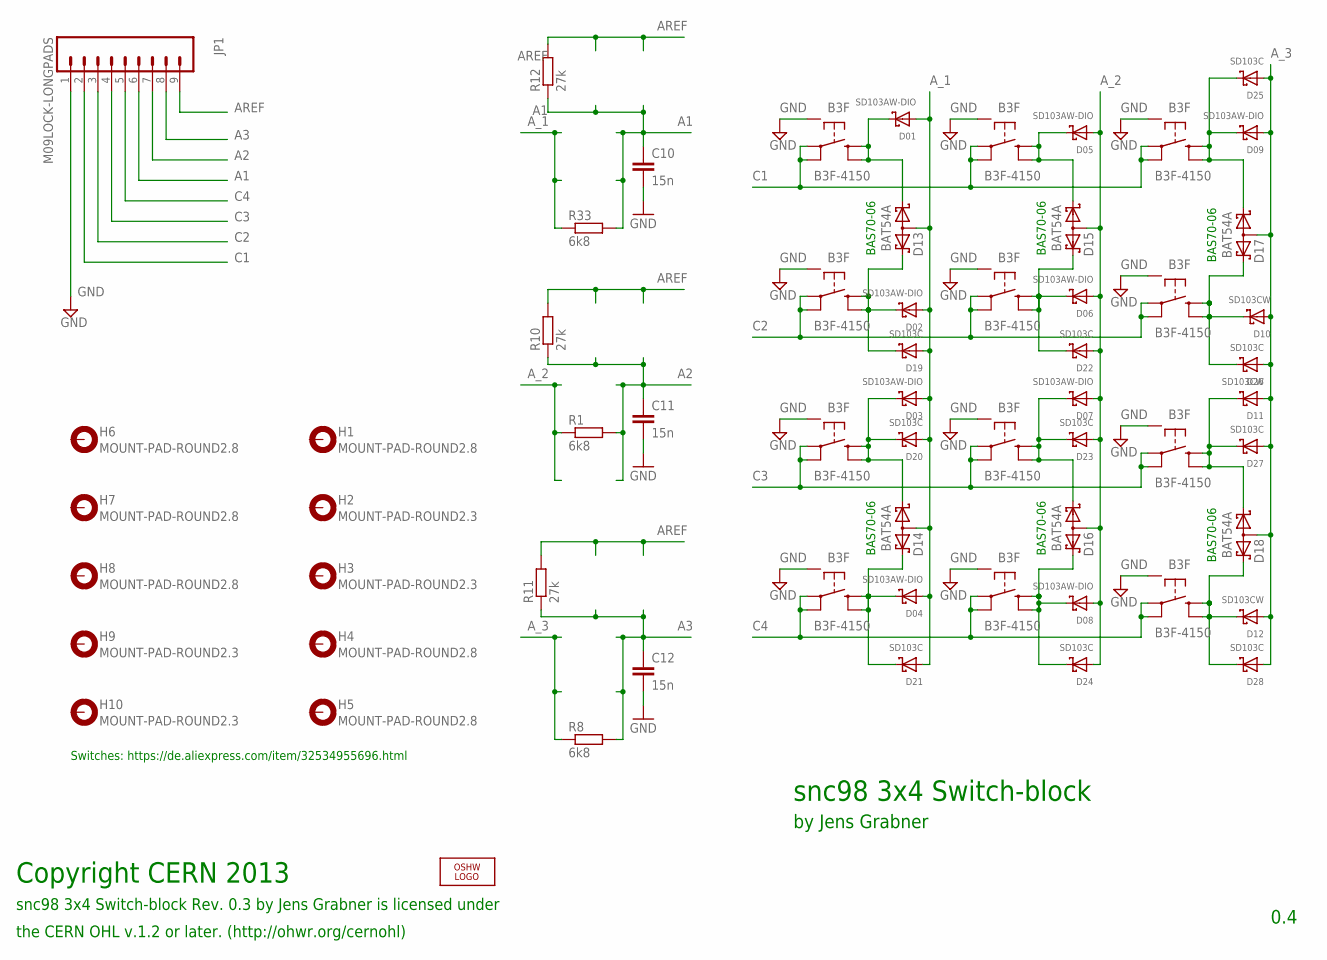
[picture p44: schematic snc98_3x4_Switch-block.sch]

Parts:
C10, C11, C12: 15n; C1206K
D01, D02, D03, D04, D05, D06, D07, D08, D09: SD103AW-DIO; SOD-123F; MPN SD103CW-7-F
D10, D11, D12: SD103CW; SOD-123F; MPN SD103CW-7-F
D13, D14, D15, D16, D17, D18: BAT54A; SOT23
D19, D20, D21, D22, D23, D24, D25, D26, D27, D28: SD103C; 280MIL-TH; MPN SD103CW-7-F
H1, H4, H5, H6, H7, H8: MOUNT-PAD-ROUND2.8; 2,8-PAD
H2, H3, H9, H10: MOUNT-PAD-ROUND2.3; 2,3-PAD
JP1: M09LOCK-LONGPADS; 1X09_LOCK_LONGPADS
LOGO1: OSHW_LOGO_8MILX0150-NT; OSHW_8X150_NOTEXT
R1, R8, R33: 6k8; M0805
R10, R11, R12: 27k; M0805
S1, S2, S3, S4, S5, S6, S7, S8, S9, S10, S11, S12: B3F-4150; TACTILE-PTH-12MM

Connections:
A1: C10.1, JP1.6, R12.1, R33.2
A2: C11.1, JP1.7, R1.2, R10.1
A3: C12.1, JP1.8, R8.2, R11.1
AREF: JP1.9, R10.2, R11.2, R12.2
A_1: D01.A, D02.A, D03.A, D04.A, D13.3 (AA), D14.3 (AA), D19.P$1 (A), D20.P$1 (A), D21.P$1 (A), R33.1
A_2: D05.A, D06.A, D07.A, D08.A, D15.3 (AA), D16.3 (AA), D22.P$1 (A), D23.P$1 (A), D24.P$1 (A), R1.1
A_3: D09.A, D10.A, D11.A, D12.A, D17.3 (AA), D18.3 (AA), D25.P$1 (A), D26.P$1 (A), D27.P$1 (A), D28.P$1 (A), R8.1
C1: JP1.2, S1.P$1 (1), S1.P$2 (2), S1.P$11 (1), S1.P$12 (2), S1.P$21 (1), S1.P$22 (2), S5.P$1 (1), S5.P$2 (2), S5.P$11 (1), S5.P$12 (2), S5.P$21 (1), S5.P$22 (2), S9.P$1 (1), S9.P$2 (2), S9.P$11 (1), S9.P$12 (2), S9.P$21 (1), S9.P$22 (2)
C2: JP1.3, S2.P$1 (1), S2.P$2 (2), S2.P$11 (1), S2.P$12 (2), S2.P$21 (1), S2.P$22 (2), S6.P$1 (1), S6.P$2 (2), S6.P$11 (1), S6.P$12 (2), S6.P$21 (1), S6.P$22 (2), S10.P$1 (1), S10.P$2 (2), S10.P$11 (1), S10.P$12 (2), S10.P$21 (1), S10.P$22 (2)
C3: JP1.4, S3.P$1 (1), S3.P$2 (2), S3.P$11 (1), S3.P$12 (2), S3.P$21 (1), S3.P$22 (2), S7.P$1 (1), S7.P$2 (2), S7.P$11 (1), S7.P$12 (2), S7.P$21 (1), S7.P$22 (2), S11.P$1 (1), S11.P$2 (2), S11.P$11 (1), S11.P$12 (2), S11.P$21 (1), S11.P$22 (2)
C4: JP1.5, S4.P$1 (1), S4.P$2 (2), S4.P$11 (1), S4.P$12 (2), S4.P$21 (1), S4.P$22 (2), S8.P$1 (1), S8.P$2 (2), S8.P$11 (1), S8.P$12 (2), S8.P$21 (1), S8.P$22 (2), S12.P$1 (1), S12.P$2 (2), S12.P$11 (1), S12.P$12 (2), S12.P$21 (1), S12.P$22 (2)
GND: C10.2, C11.2, C12.2, JP1.1, S1.P$15 (5), S2.P$15 (5), S3.P$15 (5), S4.P$15 (5), S5.P$15 (5), S6.P$15 (5), S7.P$15 (5), S8.P$15 (5), S9.P$15 (5), S10.P$15 (5), S11.P$15 (5), S12.P$15 (5)
unnamed: D04.C, D14.2 (K2), D21.P$2 (C), S4.P$3 (3), S4.P$4 (4), S4.P$13 (3), S4.P$14 (4), S4.P$23 (3), S4.P$24 (4)
unnamed: D01.C, D13.1 (K1), S1.P$3 (3), S1.P$4 (4), S1.P$13 (3), S1.P$14 (4), S1.P$23 (3), S1.P$24 (4)
unnamed: D09.C, D17.1 (K1), D25.P$2 (C), S9.P$3 (3), S9.P$4 (4), S9.P$13 (3), S9.P$14 (4), S9.P$23 (3), S9.P$24 (4)
unnamed: D10.C, D17.2 (K2), D26.P$2 (C), S10.P$3 (3), S10.P$4 (4), S10.P$13 (3), S10.P$14 (4), S10.P$23 (3), S10.P$24 (4)
unnamed: D02.C, D13.2 (K2), D19.P$2 (C), S2.P$3 (3), S2.P$4 (4), S2.P$13 (3), S2.P$14 (4), S2.P$23 (3), S2.P$24 (4)
unnamed: D11.C, D18.1 (K1), D27.P$2 (C), S11.P$3 (3), S11.P$4 (4), S11.P$13 (3), S11.P$14 (4), S11.P$23 (3), S11.P$24 (4)
unnamed: D12.C, D18.2 (K2), D28.P$2 (C), S12.P$3 (3), S12.P$4 (4), S12.P$13 (3), S12.P$14 (4), S12.P$23 (3), S12.P$24 (4)
unnamed: D05.C, D15.1 (K1), S5.P$3 (3), S5.P$4 (4), S5.P$13 (3), S5.P$14 (4), S5.P$23 (3), S5.P$24 (4)
unnamed: D06.C, D15.2 (K2), D22.P$2 (C), S6.P$3 (3), S6.P$4 (4), S6.P$13 (3), S6.P$14 (4), S6.P$23 (3), S6.P$24 (4)
unnamed: D07.C, D16.1 (K1), D23.P$2 (C), S7.P$3 (3), S7.P$4 (4), S7.P$13 (3), S7.P$14 (4), S7.P$23 (3), S7.P$24 (4)
unnamed: D08.C, D16.2 (K2), D24.P$2 (C), S8.P$3 (3), S8.P$4 (4), S8.P$13 (3), S8.P$14 (4), S8.P$23 (3), S8.P$24 (4)
unnamed: D03.C, D14.1 (K1), D20.P$2 (C), S3.P$3 (3), S3.P$4 (4), S3.P$13 (3), S3.P$14 (4), S3.P$23 (3), S3.P$24 (4)

Notes on the sheet:
snc98 3x4 Switch-block
by Jens Grabner
0.4
snc98 3x4 Switch-block Rev. 0.3 by Jens Grabner is licensed under
Copyright CERN 2013
the CERN OHL v.1.2 or later. (http://ohwr.org/cernohl)
BAS70-06
Switches: https://de.aliexpress.com/item/32534955696.html

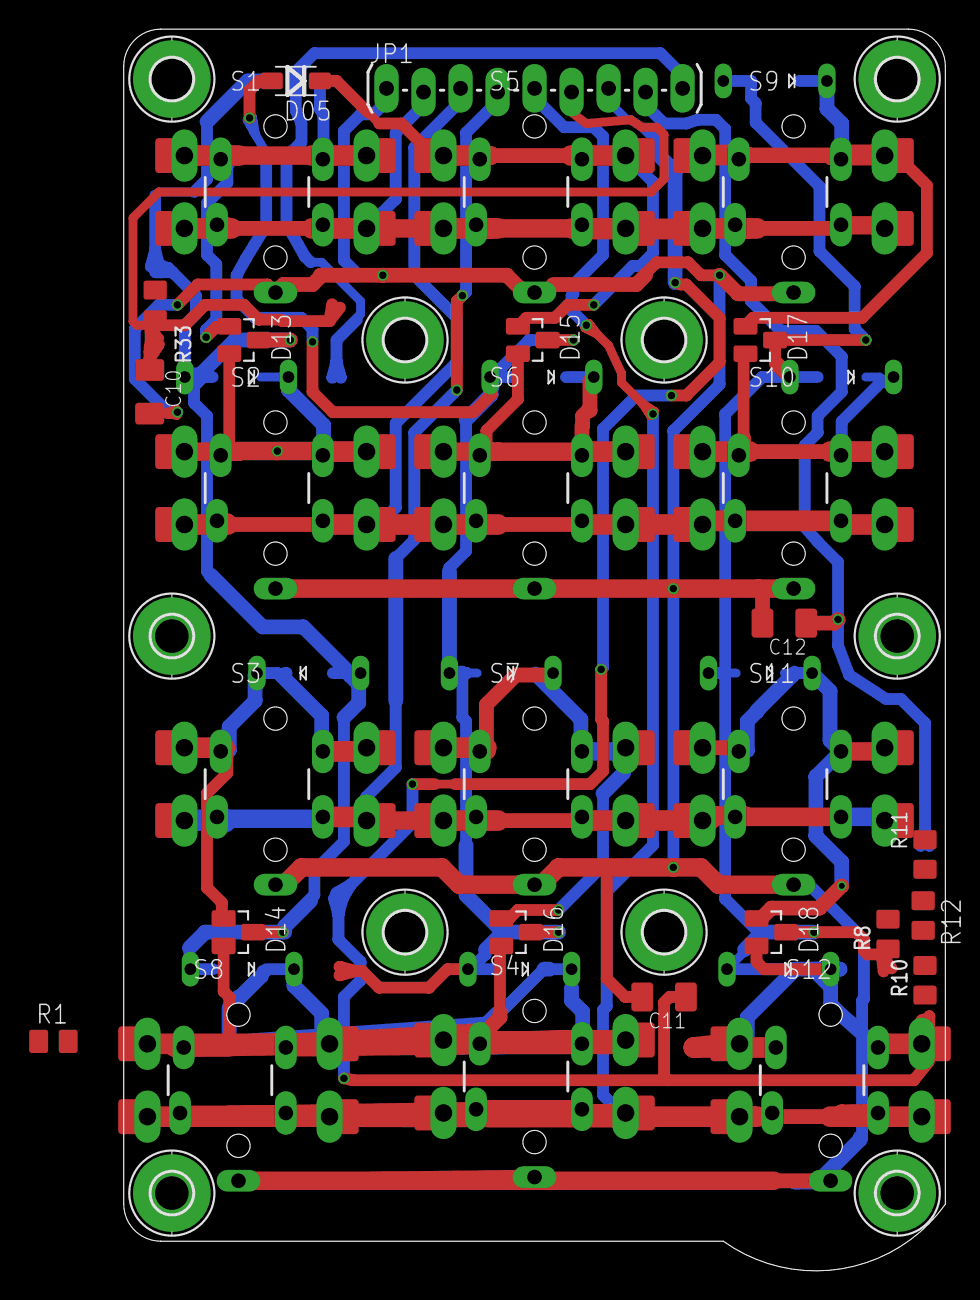
[picture p45: board snc98_3x4_Switch-block.brd from above]

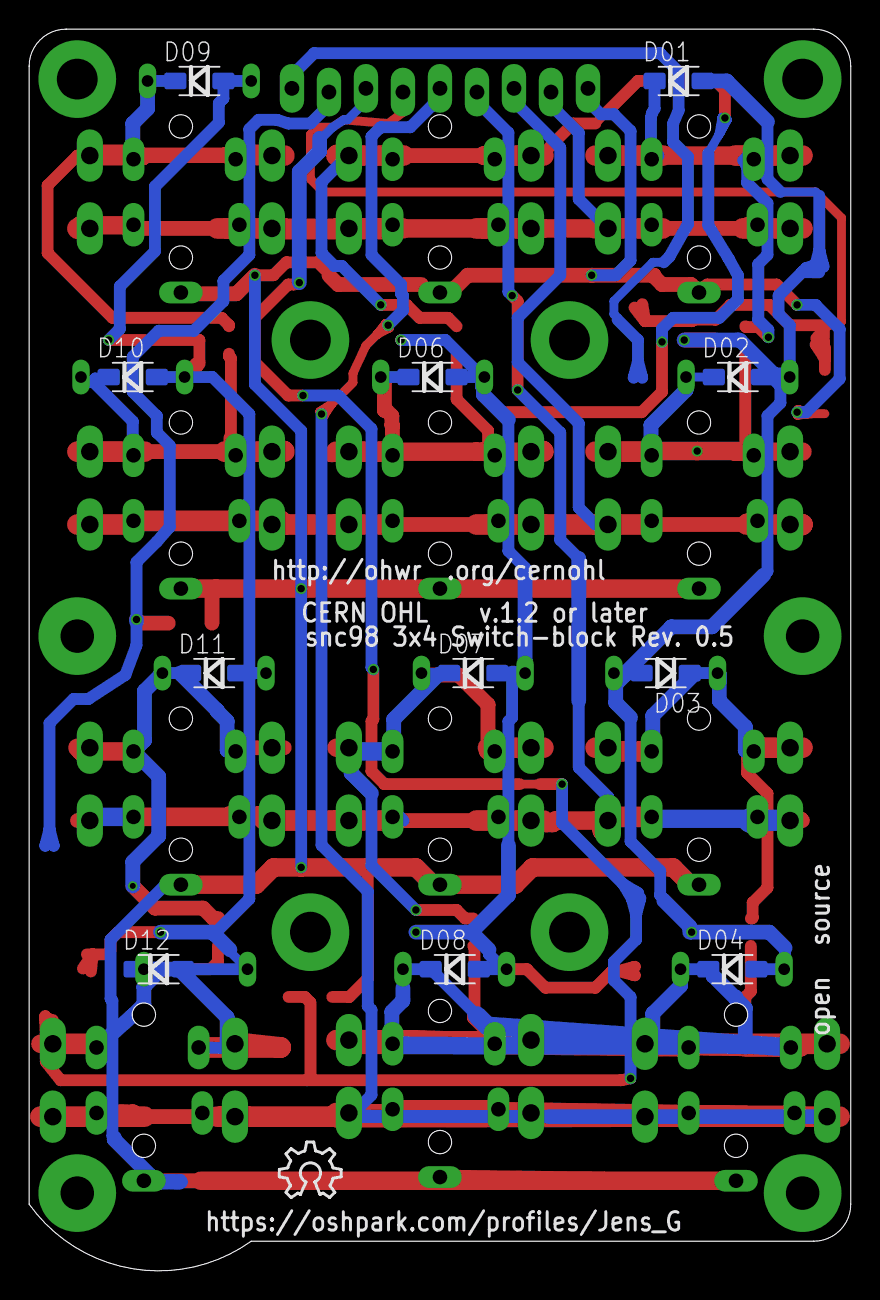
[picture p46: board snc98_3x4_Switch-block.brd from below]

Board: 2 copper layers, 56.4 x 85.2 mm, 61 parts (12 on the bottom side), 24 nets.
