JensGrabner/snc98_Slash-Number-Calculator/(commit log)

2016-03-16 Initial Release 0.2g
    .. this is a Beginning
    [7segmentdesign_new.xls, Switch_Calculator.xls, calculator_15-Digit.brd, calculator_15-Digit.sch]
2016-03-24 change switch from x^3 to INT and invers
    [Switch_Calculator.xls, calculator_15-Digit.sch]
2016-03-26 Doku "Switch_mechanical"
2016-04-01 Switch_Layout - smal changes on Layout
2016-04-10 add Display rotate
    [Switch_Calculator.xls]
2016-04-21 Layout Switch change - Intg.Fra - to - Ip.Fp -
2016-04-26 Switch-block added
    [Switch_Calculator.xls, snc98_3x4_Switch-block.brd, snc98_3x4_Switch-block.sch]
2016-05-30 Switch-block changed Rev.02
    [calculator_15-Digit.brd, calculator_15-Digit.sch, snc98_3x4_Switch-block.brd, snc98_3x4_Switch-block.sch]
2016-06-08 Switch-block Filter added
    [Switch_Calculator.xls, calculator_15-Digit.brd, calculator_15-Digit.sch, snc98_3x4_Switch-block.brd, snc98_3x4_Switch-block.sch]
2016-06-09 New Picture "Switch mechanical"
    [calculator_15-Digit.brd, snc98_3x4_Switch-block.brd]
2016-07-17 Debug_Level 13: - Protokoll Statepoint
    [snc98_3x4_Switch-block.brd]
2016-07-19 Debuglevel 13 - Protokoll Statepoint
    [calculator_15-Digit.brd, calculator_15-Digit.sch, snc98_3x4_Switch-block.brd]
2016-09-27 new Switch Layout - with Kipptaster
    [Switch_Calculator.xls, calculator_15-Digit.brd, calculator_15-Digit.sch, snc98_3x4_Switch-block.brd, snc98_3x4_Switch-block.sch, snc98_Display_15x7-Segment_LED.sch]
2016-11-08 AVRational mul(); add(); div_x()
    [7segmentdesign_new.xls, Switch_mechanical.dxf, snc98_3x4_Switch-block.brd, snc98_3x4_Switch-block.sch]
2017-01-27 MR(); MS(); M+=(); Display Status
    Display whe to or more switch pressed.
    [7segmentdesign_new.xls, Switch_Calculator.xls, Switch_mechanical.dxf, calculator_15-Digit.brd, calculator_15-Digit.sch, snc98_3x4_Switch-block.brd, snc98_Display_15x7-Segment_LED.brd, snc98_Display_15x7-Segment_LED.sch]
2017-03-07 RingBufCPP added
    [Switch_Calculator.xls, calculator_15-Digit.brd, calculator_15-Digit.sch]
2017-03-27 sqrt() - 18-Digit
    [Switch_Calculator.xls]
2017-04-14 New Hardware Design V0.4
    [calculator_15-Digit.brd, calculator_15-Digit.sch, snc98_3x4_Switch-block.brd, snc98_Display_15x7-Segment_LED.brd, snc98_Display_15x7-Segment_LED.sch]
2017-05-02 New Hardware Design V0.4a
    [Switch_Calculator.xls, calculator_15-Digit.brd, calculator_15-Digit.sch]
2017-05-13 itoa_ljust w/ default: switch-case
2017-06-20 Display .. 5x LTD040AUE-101A 3-digit_Display
    [7segmentdesign_new.xls, Switch_Calculator.xls, calculator_15-Digit.brd, calculator_15-Digit.sch, snc98_Display_15x7-Segment_3-digitDisplay.brd, snc98_Display_15x7-Segment_3-digitDisplay.sch]
2017-08-15 snc98_main_cpu V1.0
    [snc98_3x4_Switch-block.brd, snc98_3x4_Switch-block.sch, snc98_Display_15x7-Segment_3-digitDisplay.brd, snc98_Display_15x7-Segment_3-digitDisplay.sch, snc98_Display_15x7-Segment_LED.brd, snc98_Display_15x7-Segment_LED.sch, snc98_main_cpu.brd, snc98_main_cpu.sch]
2017-09-30 (+ - * /) with 2 Numbers
    [7segmentdesign_new.xls]
2017-10-27 new Reset on Main:cpu
    [snc98_main_cpu.brd, snc98_main_cpu.sch]
2017-11-01 add Iterated Means (AM) (GM) (HM)
    [Switch_Calculator.xls]
2017-11-22 Main_cpu_rev_0.95 - Add Onewire DS18B20
    [snc98_main_cpu.brd, snc98_main_cpu.sch]
2017-12-16 AGM - Arithmetic Geometric Mean added
    [7segmentdesign_new.xls, Switch_Calculator.xls]
2017-12-26 new Switch_mechanical.pdf
    [Switch_mechanical.dxf]
2018-01-28 fine with 2 numbers
    [7segmentdesign_new.xls, snc98_main_cpu.brd, snc98_main_cpu.sch]
2018-02-17 Add new Function: mod (modular)
    [7segmentdesign_new.xls, Switch_Calculator.xls, snc98_main_cpu.brd, snc98_main_cpu.sch]
2018-03-12 Work like WIN_7 Calculator in "Standard Mode"
    [snc98_Display_15x7-Segment_3-digitDisplay.brd, snc98_Display_15x7-Segment_3-digitDisplay.sch, snc98_Display_15x7-Segment_LED.brd, snc98_Display_15x7-Segment_LED.sch, snc98_main_cpu.brd, snc98_main_cpu.sch]
2018-04-18 Version 4 mechanical change
    [7segmentdesign_new.xls, Switch_Calculator.xls, Switch_mechanical.dwg, Switch_mechanical.dxf, snc98_Display_15x7-Seg_1-digit_SC39.brd, snc98_Display_15x7-Seg_1-digit_SC39.sch, snc98_Display_15x7-Seg_1-digit_SC52.brd, snc98_Display_15x7-Seg_1-digit_SC52.sch]
2018-04-18 Switch_mechanical.pdf new
2018-05-01 new keyboard plate
    [Switch_mechanical.dwg, Switch_mechanical.dxf, snc98_keyboard_plate.sch]
2018-05-31 V 5.0 Hardware - Design
    [snc98_3x4_Switch-block.brd, snc98_Display_15x7-Seg_3-digit_LTD056.brd, snc98_Display_15x7-Seg_3-digit_LTD056.sch, snc98_keyboard_plate.sch, snc98_main_cpu.brd, snc98_main_cpu.sch]
2018-06-24 add Memory+ for all Numbers
    [snc98_main_cpu.brd]
2018-09-24 add function ln() - natural log
    [7segmentdesign_new.xls]
2018-09-28 log(x,b) log(x) to base (b) added
    [7segmentdesign_new.xls]
2018-10-08 2^x, a^x, e^x, 10^x added
    [7segmentdesign_new.xls]
2018-11-04 add .. Factorial Function n!
    [7segmentdesign_new.xls]
2018-12-03 PCB cleaning V1.1
    [7segmentdesign_new.xls, snc98_3x4_Switch-block.brd, snc98_3x4_Switch-block.sch, snc98_Display_15x7-Seg_1-digit_SC39.brd, snc98_Display_15x7-Seg_1-digit_SC39.sch, snc98_Display_15x7-Seg_1-digit_SC52.brd, snc98_Display_15x7-Seg_1-digit_SC52.sch, snc98_Display_15x7-Seg_3-digit_LTD040.brd]
2019-01-14 sinh()_cosh()_tanh() added
    [snc98_3x4_Switch-block.brd, snc98_3x4_Switch-block.sch, snc98_Display_15x7-Seg_3-digit_LTD056.brd, snc98_Display_15x7-Seg_3-digit_LTD056.sch, snc98_keyboard_plate.sch, snc98_main_cpu.brd, snc98_main_cpu.sch]
2019-02-03 PCB - add Tear Drop
    [7segmentdesign_new.xls, snc98_3x4_Switch-block.brd, snc98_3x4_Switch-block.sch, snc98_Display_15x7-Seg_1-digit_SC39.brd, snc98_Display_15x7-Seg_1-digit_SC52.brd, snc98_Display_15x7-Seg_3-digit_LTD040.brd, snc98_Display_15x7-Seg_3-digit_LTD056.brd, snc98_main_cpu.brd]
2019-02-19 add - atanh()
    [7segmentdesign_new.xls]
2019-03-04 Gerber file added
    [snc98_3x4_Switch-block.brd, snc98_3x4_Switch-block.sch, snc98_Display_15x7-Seg_3-digit_LTD056.brd, snc98_Display_15x7-Seg_3-digit_LTD056.sch, snc98_main_cpu.brd, snc98_main_cpu.sch]
2019-04-03 more accurate Factorial Function n!
    [7segmentdesign_new.xls, snc98_3x4_Switch-block_a.csv, snc98_3x4_Switch-block_b.csv, snc98_Display_15x7-Seg_3-digit_LTD056.brd, snc98_Display_15x7-Seg_3-digit_LTD056.csv, snc98_Display_15x7-Seg_3-digit_LTD056.sch, snc98_main_cpu.brd, snc98_main_cpu.csv]
2019-04-07 Gamma(x) = (x-1)! .. 0 < x <= 72
    [snc98_keyboard_plate_V-Cut.sch]
2019-10-16 int96_a correction
    input and output from int32_t int64_t checked.
    [snc98.ino]
2020-03-04 cbrt_int96
    cbrt added
    [snc98_3x4_Switch-block.brd, snc98_3x4_Switch-block.sch, snc98_3x4_Switch-block_a.csv, snc98_3x4_Switch-block_b.csv, snc98_Display_15x7-Seg_3-digit_LTD056.csv, snc98_main_cpu.brd, snc98_main_cpu.csv, snc98_main_cpu.sch]
2020-09-10 add factorial() - today from -72 to +72.
    add factorial() - today from -72 to +72.
    [BOM_all.xls, Switch_Calculator.xls, Switch_Calculator.xlsx, snc98_3x4_Switch-block.brd, snc98_3x4_Switch-block.sch, snc98_main_cpu.brd, snc98_main_cpu.sch]
2020-09-20 M+ M- Mx M/ -- added
    Initial: M+ M- Mx M/
    [BOM_all.xls, Switch_Calculator.xlsx]
2020-11-22 add_mul_spezial()
    add_mul_spezial()
    [Switch_Calculator.xlsx]
2021-03-25 update 02
    [Switch_Calculator.xls, Switch_Calculator.xlsx]
2021-03-29 "show" Matisse 14-digit added
    [Switch_Calculator.xls]
2021-05-16 uint32_t sqrt(uint64_t num)
    new sqrt for integer
    [Switch_Calculator.xls, qbrt_test.xls]
2021-11-27 add Dokument "The_flipped_continued_fraction.pdf"
    [snc98_3x4_Switch-block.brd, snc98_3x4_Switch-block.sch, snc98_3x4_Switch-cherry_ml.brd, snc98_3x4_Switch-cherry_ml.sch, snc98_3x4_Switch-futuba.brd, snc98_3x4_Switch-futuba.sch]
2022-08-05 Difﬁcult_problems Dokument
    [7segmentdesign_new.xls, Switch_Calculator.xls, qbrt_test.xls, snc98_3x4_Switch-block.brd, snc98_3x4_Switch-block.sch, snc98_3x4_Switch-cherry_ml.brd, snc98_3x4_Switch-cherry_ml.sch, snc98_3x4_Switch-futuba.brd]
