JensGrabner/snc98_Slash-Number-Calculator/(notices)

Notices in the files:
Hardware/eagle/6_6_0/snc98_Display_15x7-Seg_3-digit_LTD056.brd:
CERN OHL v.1.3
parts and their libraries:
SparkFun-Electromechanical: Licensing: Creative Commons ShareAlike 4.0 International - https://creativecommons.org/licenses/by-sa/4.0
SparkFun-Connectors: Licensing: CC v3.0 Share-Alike You are welcome to use this library for commercial purposes.
